HEAPLab/marco-ram-board/bom/marco-ram-board.ods

Component Count: | 188
Ref | Qnty | Value | Cmp name | Footprint
C201, C202, C319, C320, | 4 | 12p | C | Capacitor_SMD:C_0603_1608Metric_Pad1.08x0.95mm_HandSolder
C203, C206, | 2 | 4.7u | C_Polarized | Capacitor_Tantalum_SMD:CP_EIA-2012-15_AVX-P_Pad1.30x1.05mm_HandSolder
C204, C205, C208, C301, C302, C303, C304, C305, C306, C307, C308, C309, C310, C311, C312, C313, C314, C315, C316, C401, C402, C403, C404, C405, C406, C407, C408, C409, C410, C411, C412, C413, C414, C415, C416, C417, C418, C419, C420, C421, C422, C423, C424, C425, C426, C427, C428, C429, C430, C431, C432, C433, C434, C435, C436, C437, C438, C439, C440, C441, C442, C443, C444, C445, C446, C447, C448, C502, C503, C505, C507, C508, C509, | 73 | 100n | C | Capacitor_SMD:C_0603_1608Metric_Pad1.08x0.95mm_HandSolder
C207, | 1 | 3.3u | C | Capacitor_SMD:C_0805_2012Metric_Pad1.18x1.45mm_HandSolder
C317, C318, C501, | 3 | 2.2u | C_Polarized | Capacitor_SMD:C_0805_2012Metric_Pad1.18x1.45mm_HandSolder
C504, C506, | 2 | 22u | C_Polarized | Capacitor_Tantalum_SMD:CP_EIA-3216-18_Kemet-A_Pad1.58x1.35mm_HandSolder
C601, | 1 | 100u | C_Polarized | Capacitor_THT:CP_Radial_D6.3mm_P2.50mm
C602, C603, C604, | 3 | 470u | C_Polarized | Capacitor_THT:CP_Radial_D8.0mm_P5.00mm
D501, D502, D602, | 3 | LED | LED | LED_SMD:LED_PLCC-2_3.4x3.0mm_KA
D601, | 1 | 1N5822 | D_Schottky | Diode_THT:D_DO-201AD_P5.08mm_Vertical_AnodeUp
FB201, FB202, FB501, | 3 | FerriteBead | FerriteBead | Inductor_SMD:L_0603_1608Metric_Pad1.05x0.95mm_HandSolder
J201, J501 | 2 | PRG_USB | USB_B_Micro | Connector_USB:USB_Mini-B_Wuerth_65100516121_Horizontal
J202, | 1 | MCU_RST | Conn_01x02_Male | Connector_PinHeader_2.54mm:PinHeader_1x02_P2.54mm_Vertical
J203, | 1 | MCU_BOOT0 | Conn_01x02_Male | Connector_PinHeader_2.54mm:PinHeader_1x02_P2.54mm_Vertical
J204, | 1 | FT_TXD | Conn_01x02_Male | Connector_PinHeader_2.54mm:PinHeader_1x02_P2.54mm_Vertical
J205, | 1 | FT_RXD | Conn_01x02_Male | Connector_PinHeader_2.54mm:PinHeader_1x02_P2.54mm_Vertical
J206, | 1 | CONN_JTAG | Conn_02x10_Odd_Even | Connector_PinSocket_2.54mm:PinSocket_2x10_P2.54mm_Vertical
J301, | 1 | CONN_MCU_SERIAL | Conn_01x05_Female | Connector_PinSocket_2.54mm:PinSocket_1x05_P2.54mm_Vertical
J302, | 1 | CONN_EXT | Conn_01x15_Female | Connector_PinSocket_2.54mm:PinSocket_1x15_P2.54mm_Vertical
J502, | 1 | SD_Card | SD_Card | marco-ram-board:SD_Hirose_DM1AA_SF_PEJ82
J503, | 1 | CONN_DISP | Conn_02x08_Odd_Even | Connector_PinSocket_2.54mm:PinSocket_2x08_P2.54mm_Vertical
J504, | 1 | RJ45_Amphenol_RJMG1BD3B8K1ANR | RJ45_Amphenol_RJMG1BD3B8K1ANR | Connector_RJ:RJ45_Amphenol_RJMG1BD3B8K1ANR
J601, | 1 | CONN_JACK_12V | Barrel_Jack_MountingPin | Connector_BarrelJack:BarrelJack_CUI_PJ-063AH_Horizontal
J602, | 1 | CONN_SCREW_12V | Screw_Terminal_01x02 | TerminalBlock_Phoenix:TerminalBlock_Phoenix_MKDS-1,5-2-5.08_1x02_P5.08mm_Horizontal
JP501, | 1 | MCU_USB_ID | SolderJumper_2_Open | Jumper:SolderJumper-2_P1.3mm_Open_RoundedPad1.0x1.5mm
L601, | 1 | 68u 5A | L | Inductor_THT:L_Toroid_Vertical_L24.6mm_W15.5mm_P11.44mm_Pulse_KM-4
Q201, | 1 | MMBT3906 | MMBT3906 | Package_TO_SOT_SMD:SOT-23
Q601, | 1 | DMP3037LSS | FDS9435A | Package_SO:SOIC-8_3.9x4.9mm_P1.27mm
R201, | 1 | 12k 1% | R | Resistor_SMD:R_0603_1608Metric_Pad0.98x0.95mm_HandSolder
R202, R206, R211, R517, R520, R522, R523, R524, R525, R601, | 9 | 1k | R | Resistor_SMD:R_0603_1608Metric_Pad0.98x0.95mm_HandSolder
R203, R210, R301, R302, R303, R504, R526, | 6 | 10k | R | Resistor_SMD:R_0603_1608Metric_Pad0.98x0.95mm_HandSolder
R204, R205, R207, R208, R209, R305, R306, R307, R508, R509, R510, R511, R512, R513, R514, | 15 | 0 | R | Resistor_SMD:R_0603_1608Metric_Pad0.98x0.95mm_HandSolder
R304, R518, R521, R505, R515, | 3 | 220 | R | Resistor_SMD:R_0603_1608Metric_Pad0.98x0.95mm_HandSolder
R501, R502, R503, R506, R507, R527, R528, | 7 | 47k | R | Resistor_SMD:R_0603_1608Metric_Pad0.98x0.95mm_HandSolder
R516, | 1 | 6.49k | R | Resistor_SMD:R_0603_1608Metric_Pad0.98x0.95mm_HandSolder
R519, | 1 | 4.7k | R | Resistor_SMD:R_0603_1608Metric_Pad0.98x0.95mm_HandSolder
SW301, | 1 | SW_RST | SW_Push | marco-ram-board:DTSMW69N
SW302, | 1 | SW_BOOT0 | SW_Push | marco-ram-board:DTSMW69N
SW501, | 1 | BTN0 | SW_Push | marco-ram-board:DTSMW69N
SW502, | 1 | BTN1 | SW_Push | marco-ram-board:DTSMW69N
SW503, | 1 | BTN2 | SW_Push | marco-ram-board:DTSMW69N
SW504, | 1 | BTN3 | SW_Push | marco-ram-board:DTSMW69N
SW601, | 1 | PWR_SW | SW_SPDT | marco-ram-board:SW_Slide_CuK_1101M2xxAxx2_SPDT_RightAngle
U201, | 1 | FT2232HL | FT2232HL | Package_QFP:LQFP-64_10x10mm_P0.5mm
U301, | 1 | STM32F765IITx | STM32F765IITx | Package_QFP:LQFP-176_24x24mm_P0.5mm
U401, U402, U403, U404, U405, U406, U407, U408, | 8 | IS42S86400D | IS42S86400D_3 | Package_SO:TSOP-II-54_22.2x10.16mm_P0.8mm
U501, | 1 | KSZ8081RNA | KSZ8081RNA | Package_DFN_QFN:QFN-24-1EP_4x4mm_P0.5mm_EP2.6x2.6mm
U601, | 1 | LM2576S-3.3 | LM2576S-3.3 | Package_TO_SOT_SMD:TO-263-5_TabPin3
Y201, | 1 | 12MHz | Crystal_GND24 | Crystal:Crystal_SMD_5032-4Pin_5.0x3.2mm
Y301, | 1 | 25MHz | Crystal_GND24 | Crystal:Crystal_SMD_5032-4Pin_5.0x3.2mm
