HEAPLab/marco-ram-board/pdf_schematic/marco-ram-board.pdf

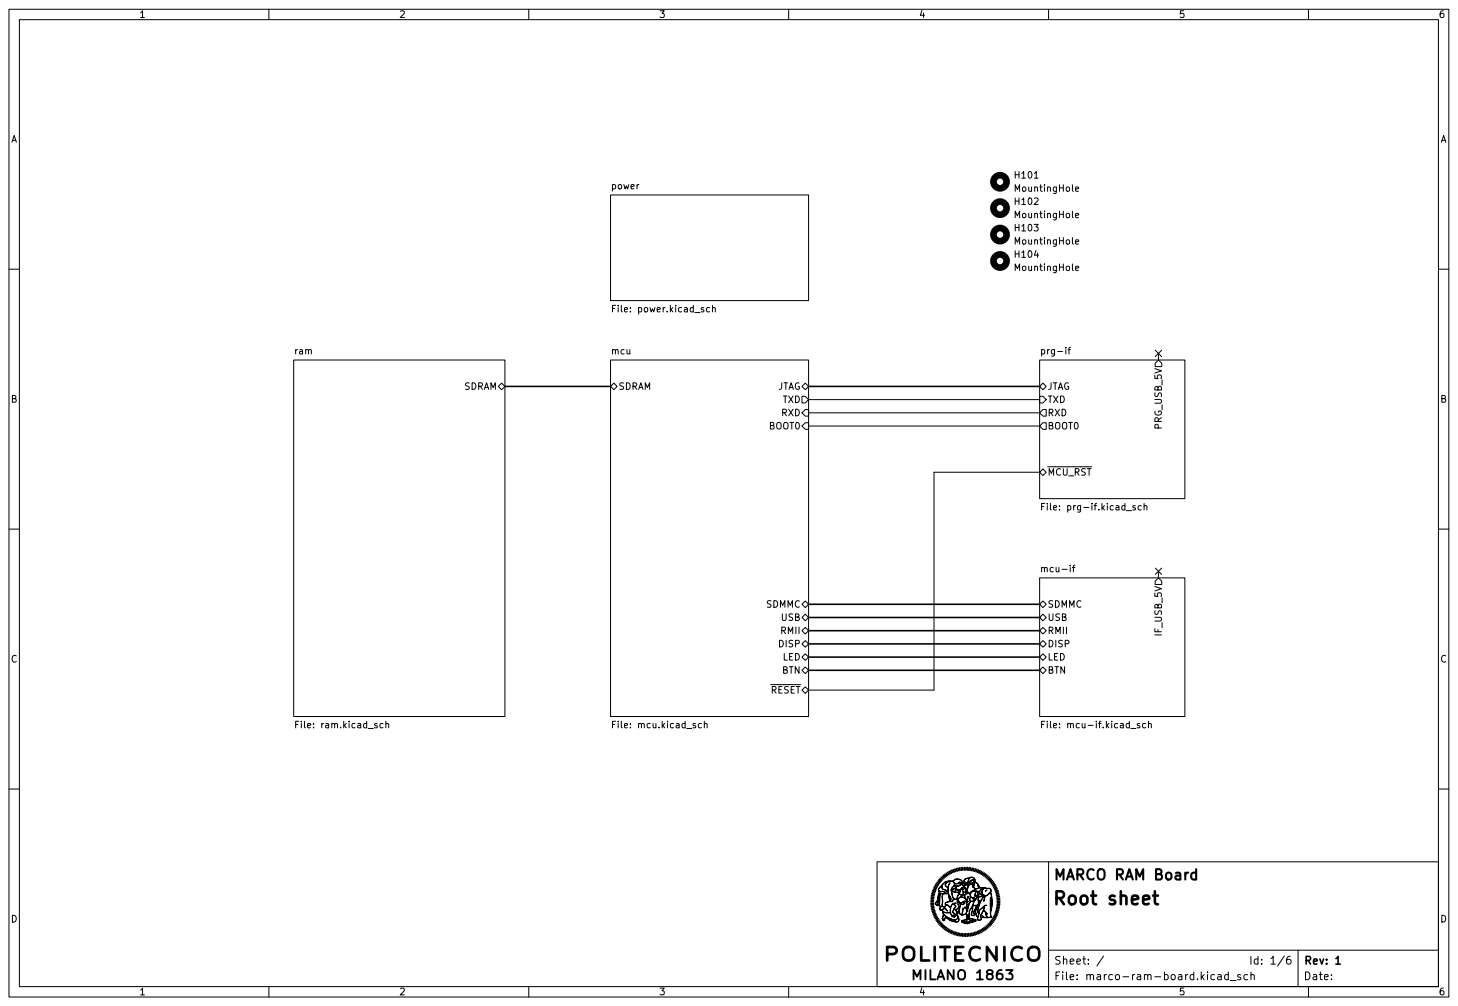
[picture p1: page 1]

BTN mcu File: mcu.kicad_sch

prg-if File: prg-if.kicad_sch SDMMC

LED mcu-if File: mcu-if.kicad_sch SDRAM

File: marco-ram-board.kicad_sch Sheet: / Root sheet

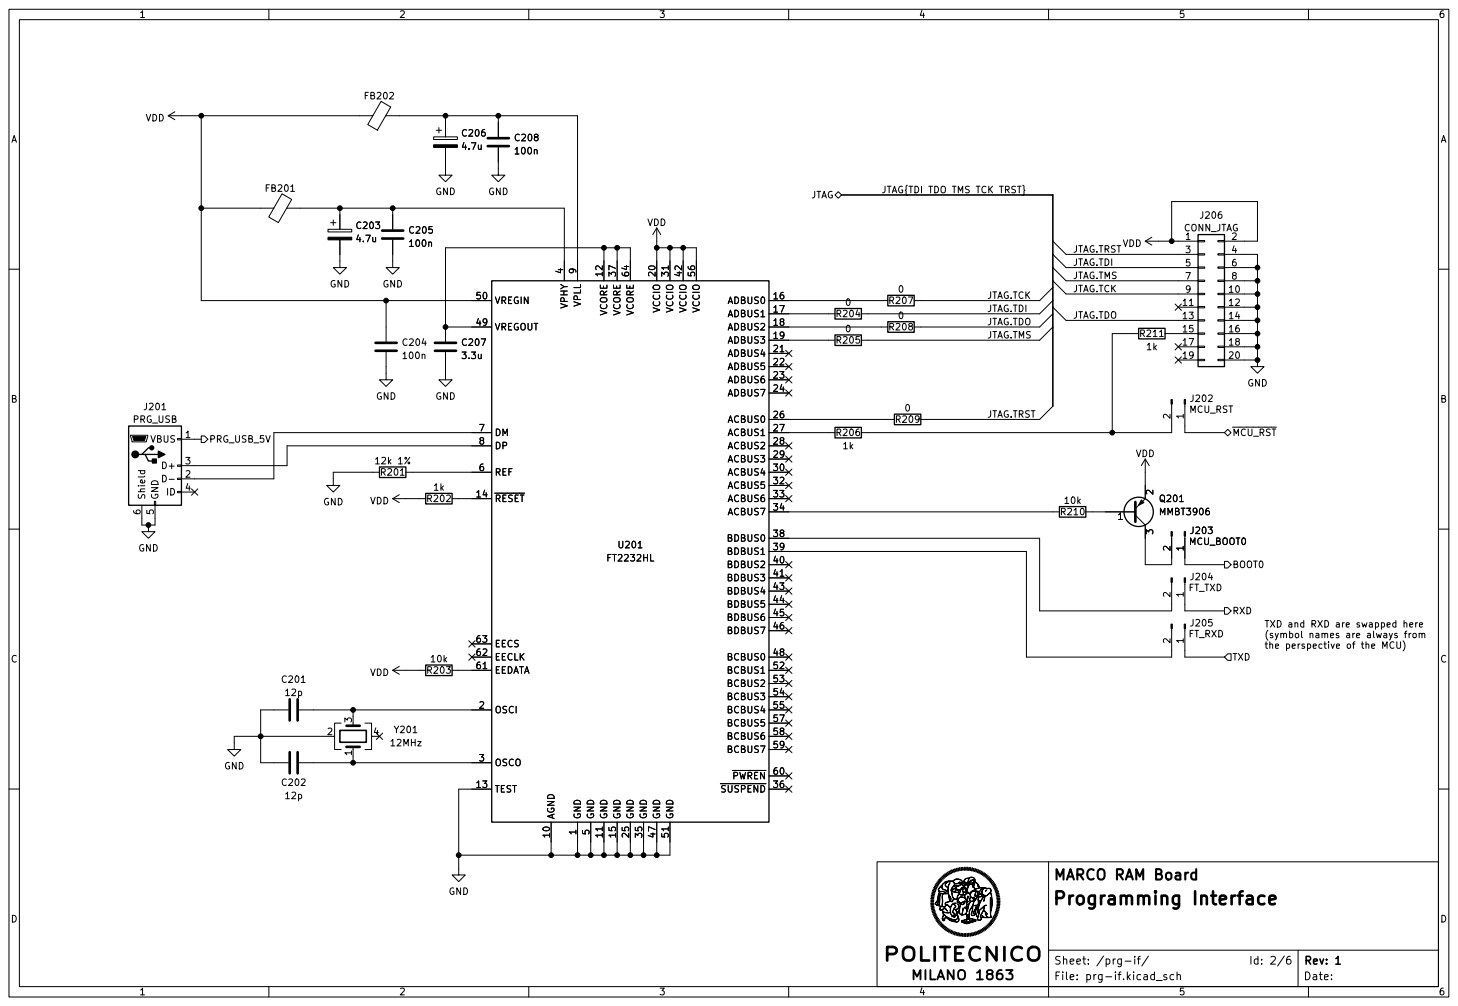
[picture p2: page 2]

1 AGND 10 GND 11 VCORE 12 TEST 13 ~{RESET} 14 GND 15 ADBUS0 16 ADBUS1 17 ADBUS2 18 ADBUS3 19 OSCI 2 VCCIO 20 ADBUS4 21 ADBUS5 22 ADBUS6 23 ADBUS7 24 GND 25 ACBUS0 26 ACBUS1 27 ACBUS2 28 ACBUS3 29 OSCO 3 ACBUS4 30 VCCIO 31 ACBUS5 32 ACBUS6 33 ACBUS7 34 GND 35

4 BDBUS2 40 BDBUS3 41 VCCIO 42 BDBUS4 43 BDBUS5 44 BDBUS6 45 BDBUS7 46 GND 47 BCBUS0 48 VREGOUT 49 GND

5 VREGIN 50 GND 51 BCBUS1 52 BCBUS2 53 BCBUS3 54 BCBUS4 55 VCCIO 56 BCBUS5 57 BCBUS6 58 BCBUS7 59 REF

JTAG.TDI JTAG.TRST

TXD and RXD are swapped here
(symbol names are always from

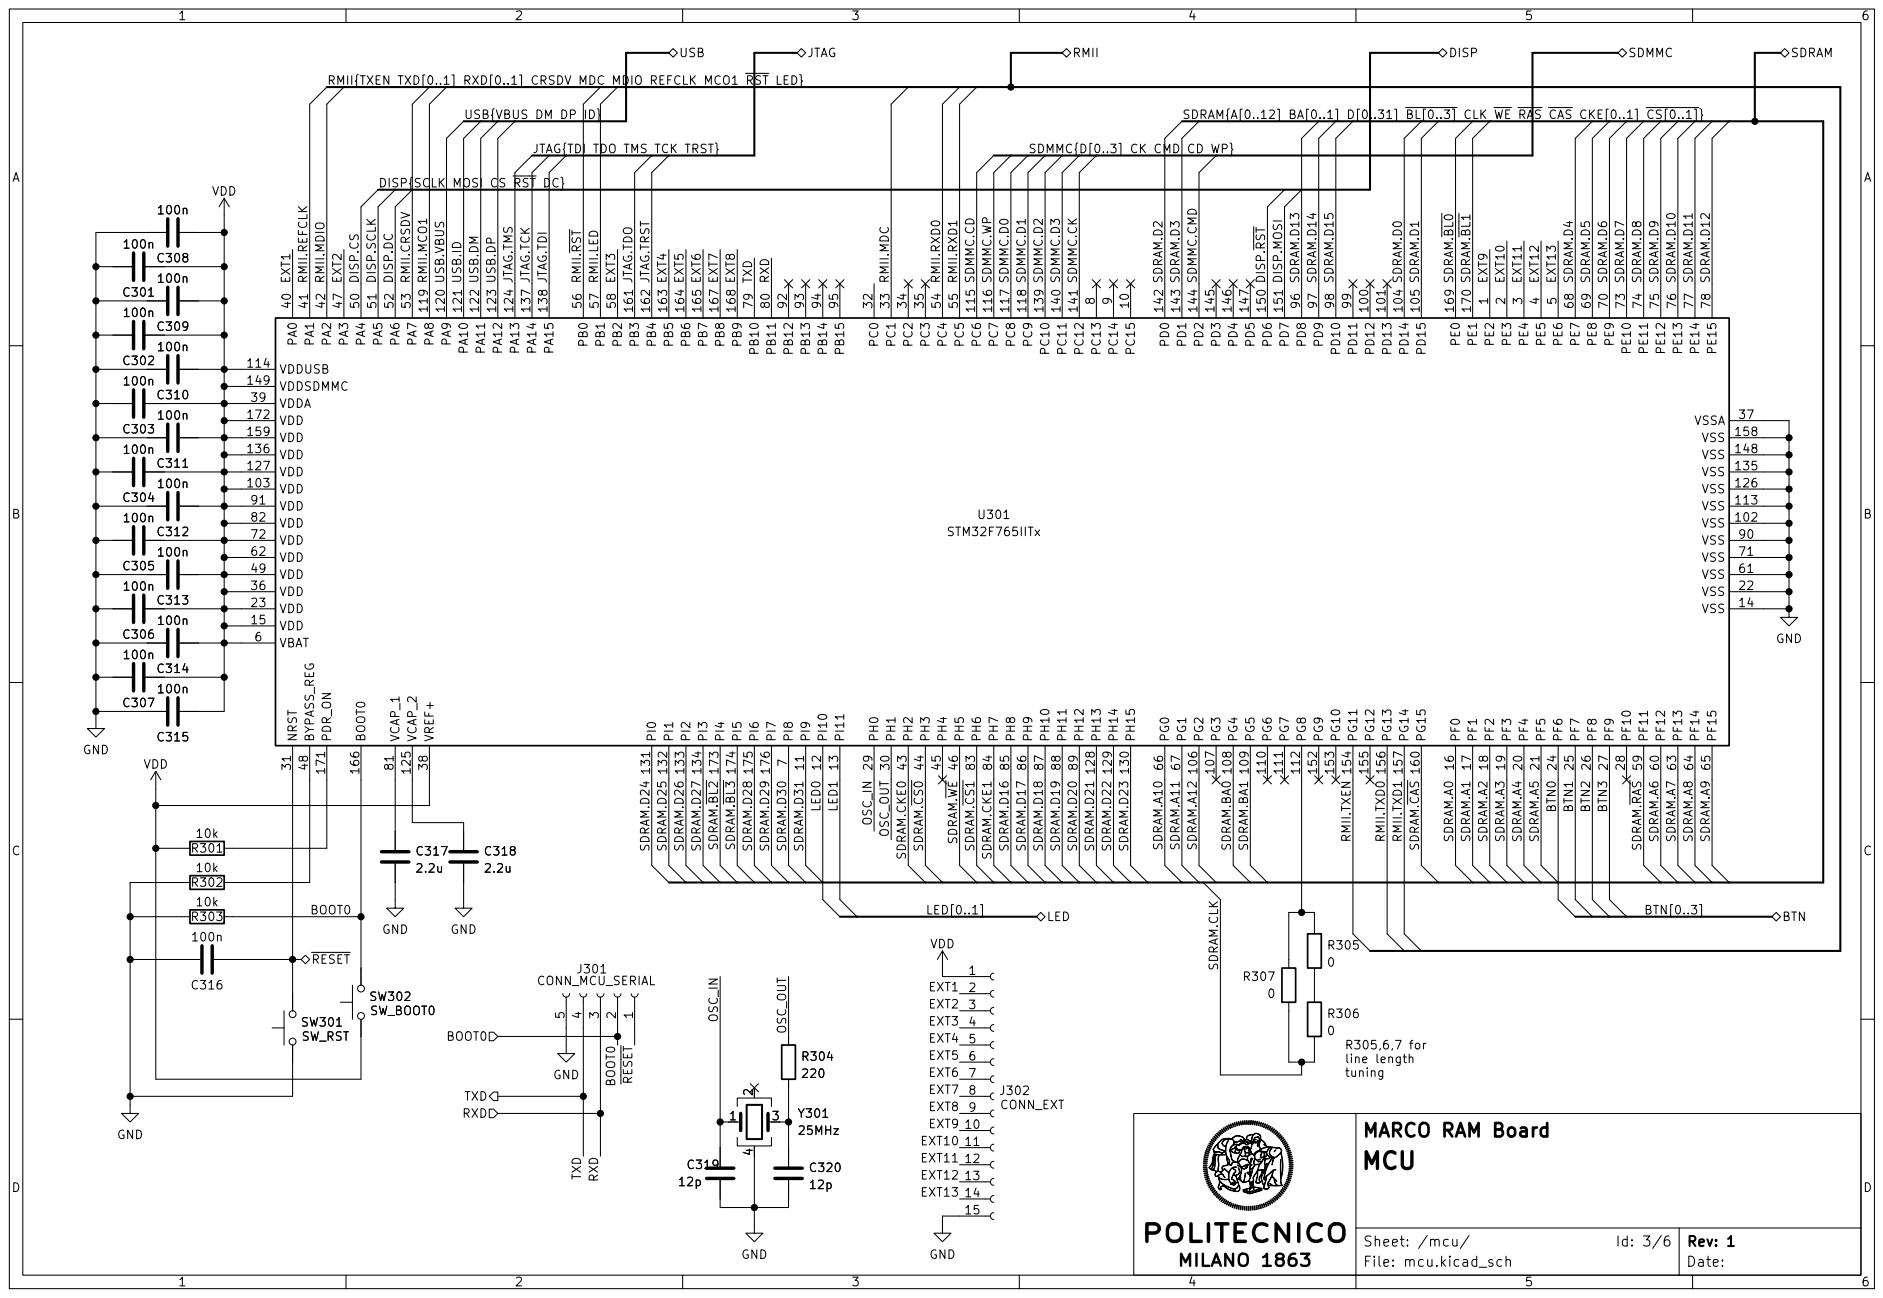
[picture p3: page 3]

File: mcu.kicad_sch Sheet: /mcu/ MCU

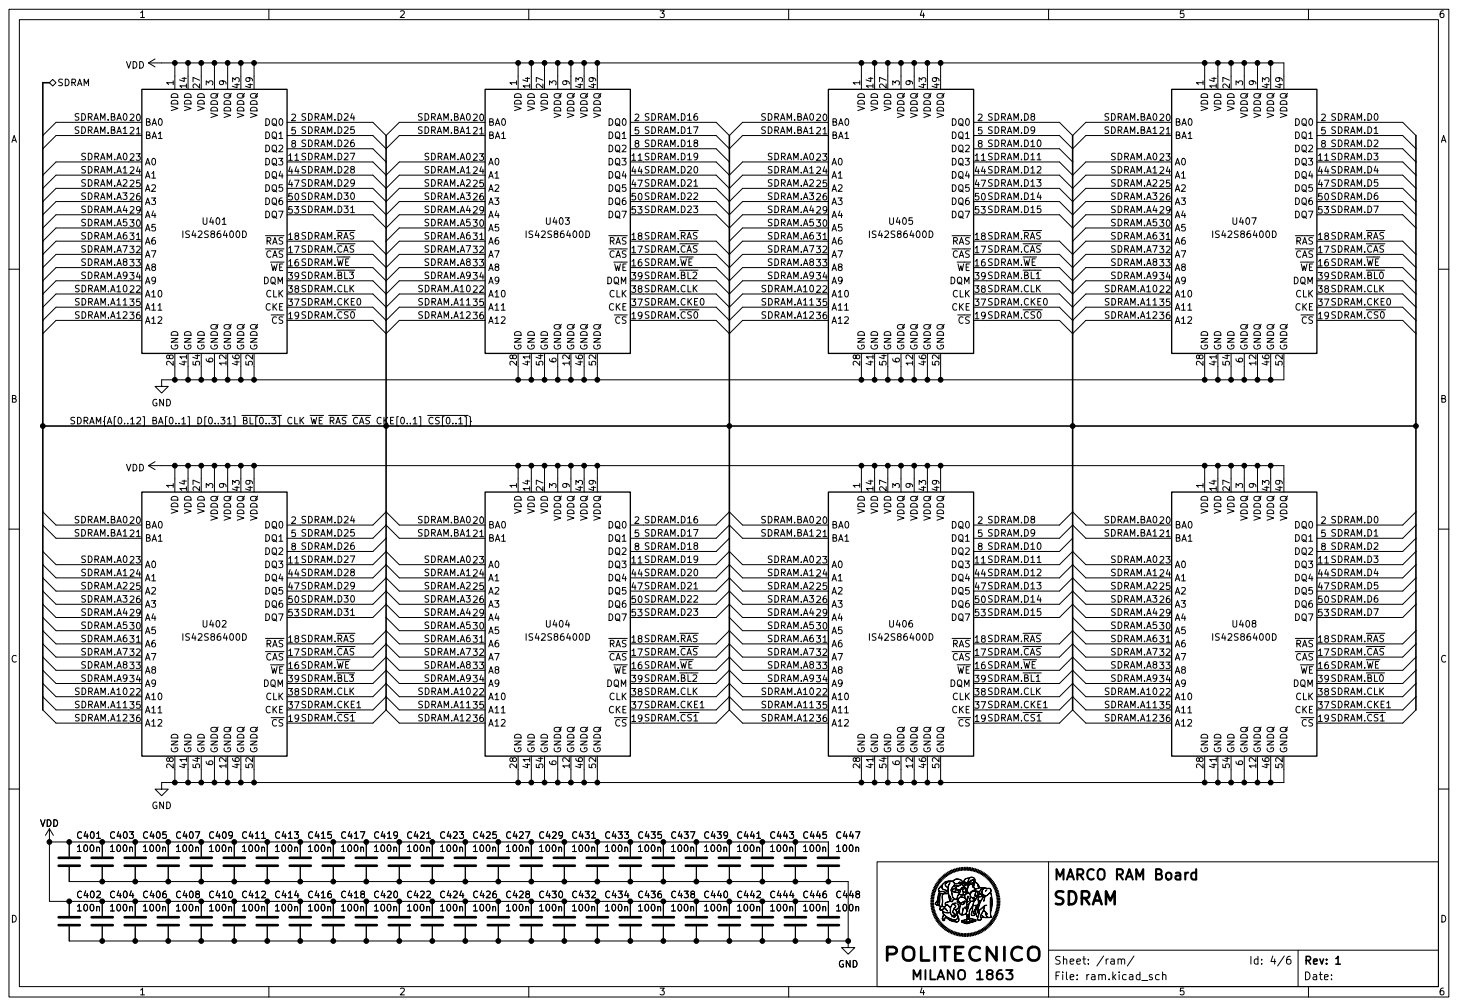
[picture p4: page 4]

SDRAM.~{CAS} SDRAM.A4 SDRAM.~{BL2} SDRAM.CLK

File: ram.kicad_sch Sheet: /ram/ SDRAM

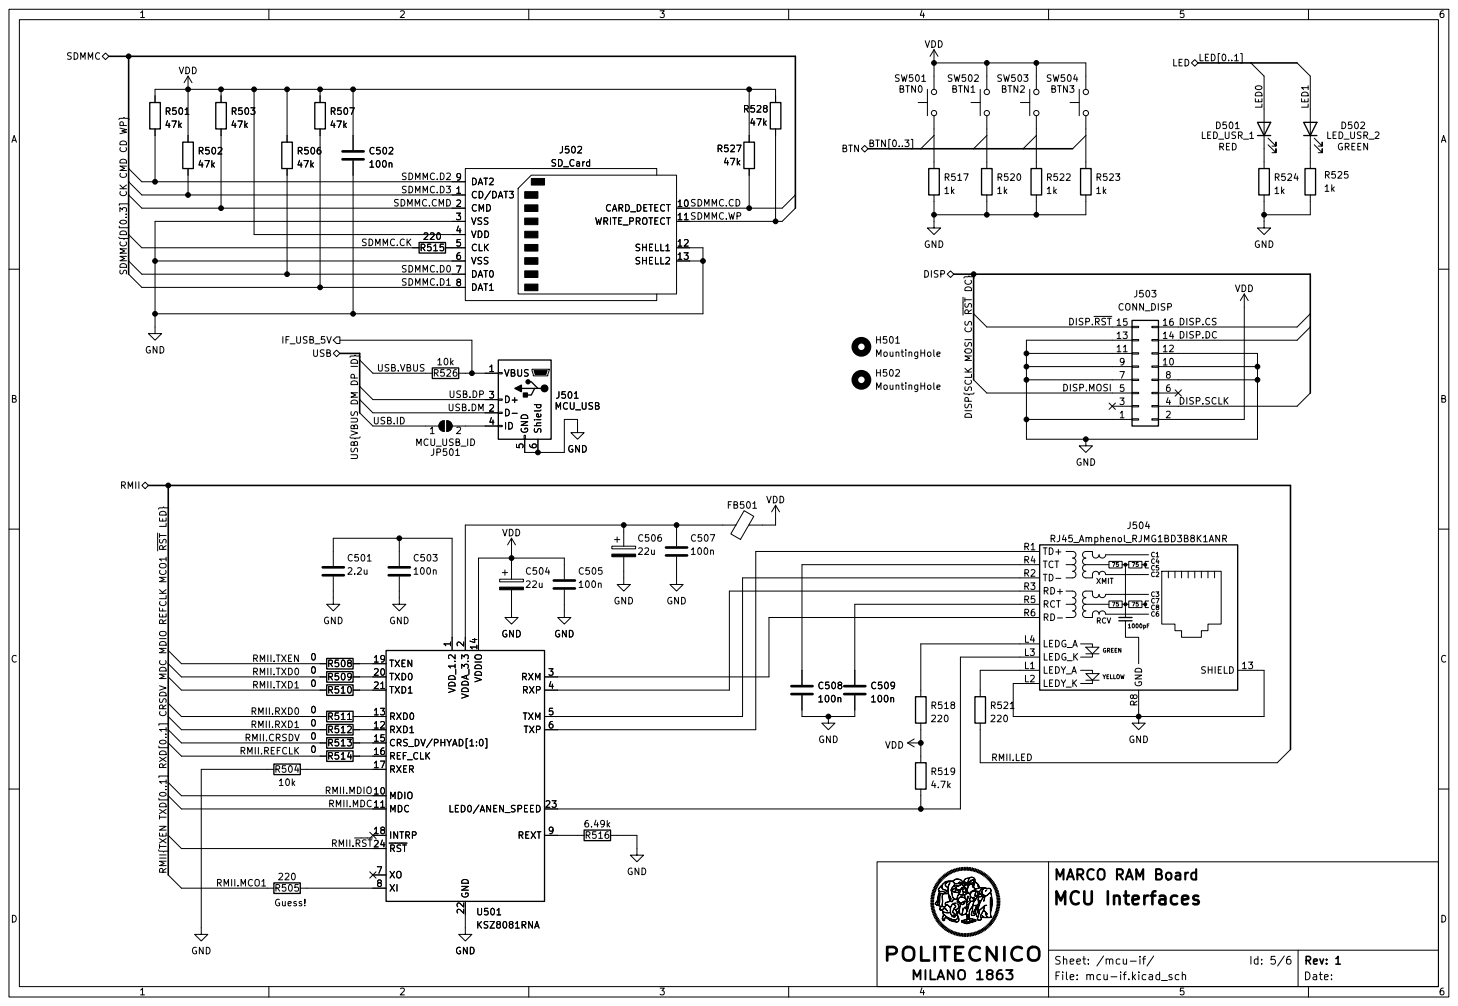
[picture p5: page 5]

11 | 12
9 | 10

RMII.MDIO
RMII.~{RST} RMII.MDC

File: mcu-if.kicad_sch Sheet: /mcu-if/ MCU Interfaces

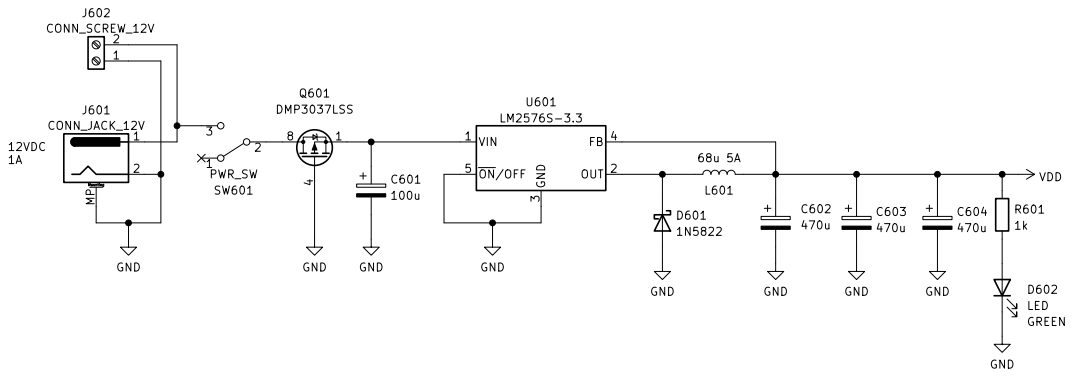
[picture p6: page 6]
