HEAPLab/marco-ram-board/marco-ram-board.kicad_pcb

## KiCad design marco-ram-board.kicad_pcb (2023-04-23)

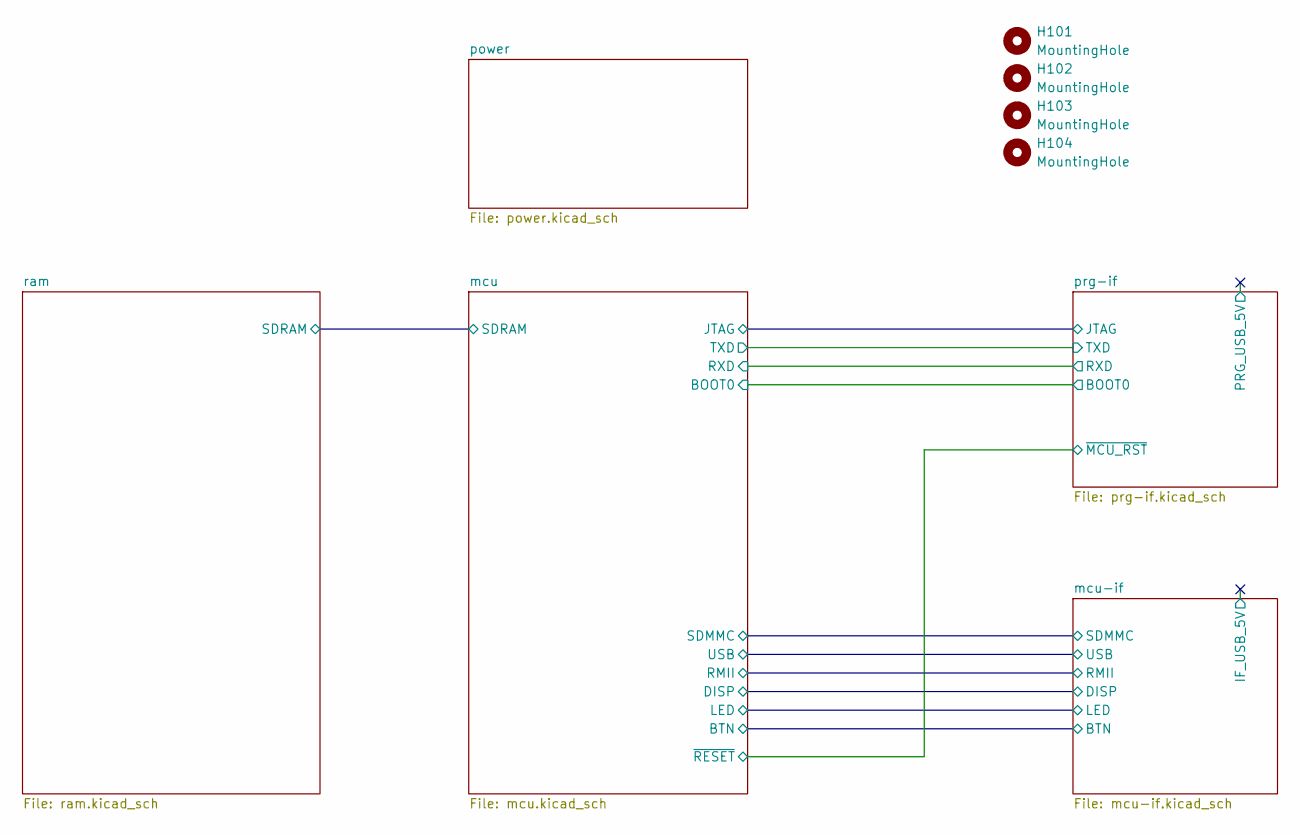
[picture p7: schematic marco-ram-board.kicad_sch, MARCO RAM Board]

Parts:
H101, H102, H103, H104: MountingHole; MountingHole_3.2mm_M3

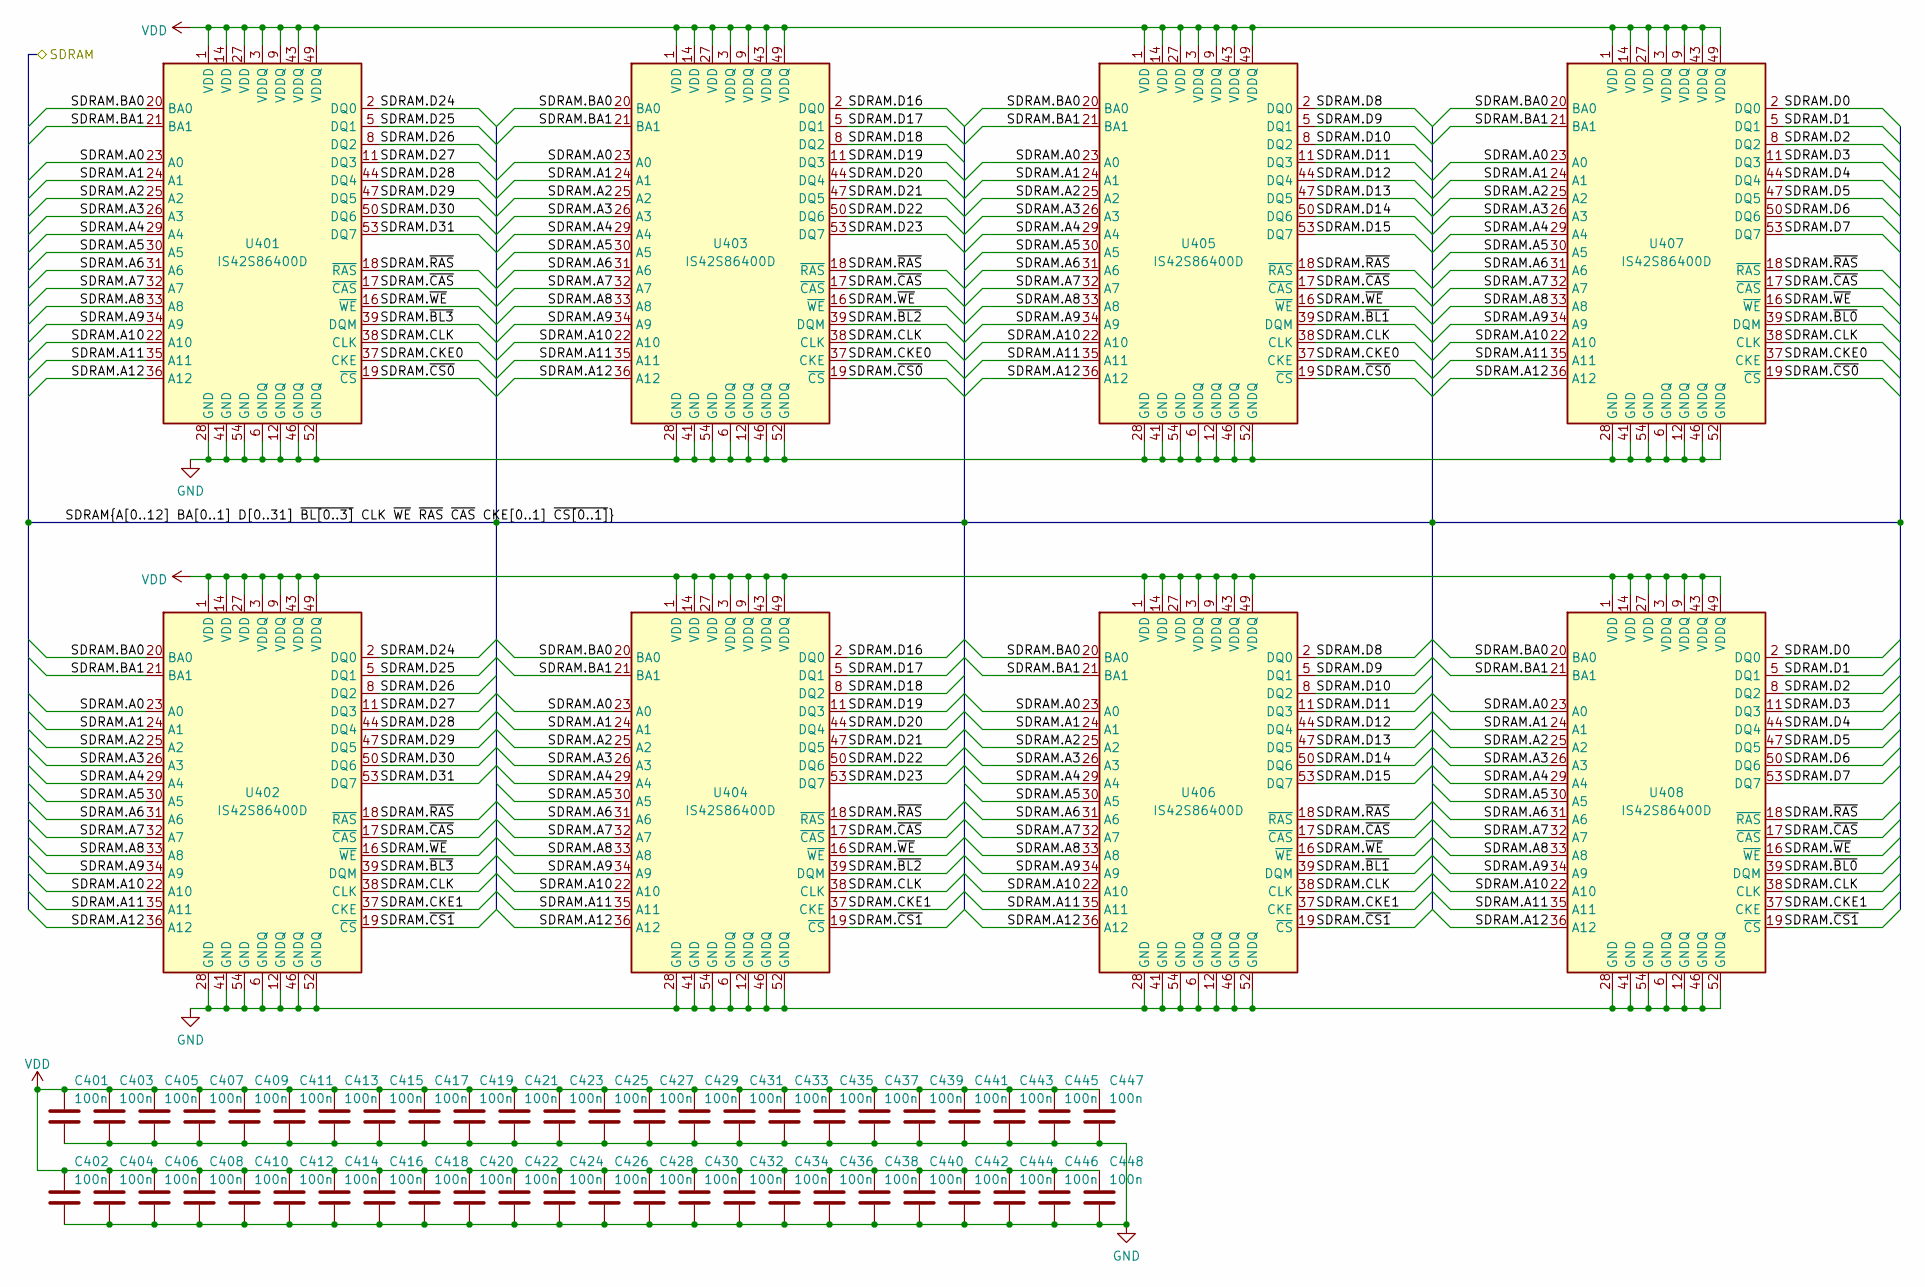
[picture p8: schematic ram.kicad_sch, MARCO RAM Board]

Parts:
C401, C402, C403, C404, C405, C406, C407, C408, C409, C410, C411, C412, C413, C414, C415, C416, C417, C418, C419, C420, C421, C422, C423, C424, C425, C426, C427, C428, C429, C430, C431, C432, C433, C434, C435, C436, C437, C438, C439, C440, C441, C442, C443, C444, C445, C446, C447, C448: 100n; C_0603_1608Metric_Pad1.08x0.95mm_HandSolder
U401, U402, U403, U404, U405, U406, U407, U408: IS42S86400D; TSOP-II-54_22.2x10.16mm_P0.8mm

Connections:
/mcu/SDRAM.A0: U401.23 (A0), U402.23 (A0), U403.23 (A0), U404.23 (A0), U405.23 (A0), U406.23 (A0), U407.23 (A0), U408.23 (A0); also elsewhere on the board
/mcu/SDRAM.A1: U401.24 (A1), U402.24 (A1), U403.24 (A1), U404.24 (A1), U405.24 (A1), U406.24 (A1), U407.24 (A1), U408.24 (A1); also elsewhere on the board
/mcu/SDRAM.A2: U401.25 (A2), U402.25 (A2), U403.25 (A2), U404.25 (A2), U405.25 (A2), U406.25 (A2), U407.25 (A2), U408.25 (A2); also elsewhere on the board
/mcu/SDRAM.A3: U401.26 (A3), U402.26 (A3), U403.26 (A3), U404.26 (A3), U405.26 (A3), U406.26 (A3), U407.26 (A3), U408.26 (A3); also elsewhere on the board
/mcu/SDRAM.A4: U401.29 (A4), U402.29 (A4), U403.29 (A4), U404.29 (A4), U405.29 (A4), U406.29 (A4), U407.29 (A4), U408.29 (A4); also elsewhere on the board
/mcu/SDRAM.A5: U401.30 (A5), U402.30 (A5), U403.30 (A5), U404.30 (A5), U405.30 (A5), U406.30 (A5), U407.30 (A5), U408.30 (A5); also elsewhere on the board
/mcu/SDRAM.A6: U401.31 (A6), U402.31 (A6), U403.31 (A6), U404.31 (A6), U405.31 (A6), U406.31 (A6), U407.31 (A6), U408.31 (A6); also elsewhere on the board
/mcu/SDRAM.A7: U401.32 (A7), U402.32 (A7), U403.32 (A7), U404.32 (A7), U405.32 (A7), U406.32 (A7), U407.32 (A7), U408.32 (A7); also elsewhere on the board
/mcu/SDRAM.A8: U401.33 (A8), U402.33 (A8), U403.33 (A8), U404.33 (A8), U405.33 (A8), U406.33 (A8), U407.33 (A8), U408.33 (A8); also elsewhere on the board
/mcu/SDRAM.A9: U401.34 (A9), U402.34 (A9), U403.34 (A9), U404.34 (A9), U405.34 (A9), U406.34 (A9), U407.34 (A9), U408.34 (A9); also elsewhere on the board
/mcu/SDRAM.A10: U401.22 (A10), U402.22 (A10), U403.22 (A10), U404.22 (A10), U405.22 (A10), U406.22 (A10), U407.22 (A10), U408.22 (A10); also elsewhere on the board
/mcu/SDRAM.A11: U401.35 (A11), U402.35 (A11), U403.35 (A11), U404.35 (A11), U405.35 (A11), U406.35 (A11), U407.35 (A11), U408.35 (A11); also elsewhere on the board
/mcu/SDRAM.A12: U401.36 (A12), U402.36 (A12), U403.36 (A12), U404.36 (A12), U405.36 (A12), U406.36 (A12), U407.36 (A12), U408.36 (A12); also elsewhere on the board
/mcu/SDRAM.BA0: U401.20 (BA0), U402.20 (BA0), U403.20 (BA0), U404.20 (BA0), U405.20 (BA0), U406.20 (BA0), U407.20 (BA0), U408.20 (BA0); also elsewhere on the board
/mcu/SDRAM.BA1: U401.21 (BA1), U402.21 (BA1), U403.21 (BA1), U404.21 (BA1), U405.21 (BA1), U406.21 (BA1), U407.21 (BA1), U408.21 (BA1); also elsewhere on the board
/mcu/SDRAM.CKE0: U401.37 (CKE), U403.37 (CKE), U405.37 (CKE), U407.37 (CKE); also elsewhere on the board
/mcu/SDRAM.CKE1: U402.37 (CKE), U404.37 (CKE), U406.37 (CKE), U408.37 (CKE); also elsewhere on the board
/mcu/SDRAM.CLK: U401.38 (CLK), U402.38 (CLK), U403.38 (CLK), U404.38 (CLK), U405.38 (CLK), U406.38 (CLK), U407.38 (CLK), U408.38 (CLK); also elsewhere on the board
/mcu/SDRAM.D0: U407.2 (DQ0), U408.2 (DQ0); also elsewhere on the board
/mcu/SDRAM.D1: U407.5 (DQ1), U408.5 (DQ1); also elsewhere on the board
/mcu/SDRAM.D2: U407.8 (DQ2), U408.8 (DQ2); also elsewhere on the board
/mcu/SDRAM.D3: U407.11 (DQ3), U408.11 (DQ3); also elsewhere on the board
/mcu/SDRAM.D4: U407.44 (DQ4), U408.44 (DQ4); also elsewhere on the board
/mcu/SDRAM.D5: U407.47 (DQ5), U408.47 (DQ5); also elsewhere on the board
/mcu/SDRAM.D6: U407.50 (DQ6), U408.50 (DQ6); also elsewhere on the board
/mcu/SDRAM.D7: U407.53 (DQ7), U408.53 (DQ7); also elsewhere on the board
/mcu/SDRAM.D8: U405.2 (DQ0), U406.2 (DQ0); also elsewhere on the board
/mcu/SDRAM.D9: U405.5 (DQ1), U406.5 (DQ1); also elsewhere on the board
/mcu/SDRAM.D10: U405.8 (DQ2), U406.8 (DQ2); also elsewhere on the board
/mcu/SDRAM.D11: U405.11 (DQ3), U406.11 (DQ3); also elsewhere on the board
/mcu/SDRAM.D12: U405.44 (DQ4), U406.44 (DQ4); also elsewhere on the board
/mcu/SDRAM.D13: U405.47 (DQ5), U406.47 (DQ5); also elsewhere on the board
/mcu/SDRAM.D14: U405.50 (DQ6), U406.50 (DQ6); also elsewhere on the board
/mcu/SDRAM.D15: U405.53 (DQ7), U406.53 (DQ7); also elsewhere on the board
/mcu/SDRAM.D16: U403.2 (DQ0), U404.2 (DQ0); also elsewhere on the board
/mcu/SDRAM.D17: U403.5 (DQ1), U404.5 (DQ1); also elsewhere on the board
/mcu/SDRAM.D18: U403.8 (DQ2), U404.8 (DQ2); also elsewhere on the board
/mcu/SDRAM.D19: U403.11 (DQ3), U404.11 (DQ3); also elsewhere on the board
/mcu/SDRAM.D20: U403.44 (DQ4), U404.44 (DQ4); also elsewhere on the board
/mcu/SDRAM.D21: U403.47 (DQ5), U404.47 (DQ5); also elsewhere on the board
/mcu/SDRAM.D22: U403.50 (DQ6), U404.50 (DQ6); also elsewhere on the board
/mcu/SDRAM.D23: U403.53 (DQ7), U404.53 (DQ7); also elsewhere on the board
/mcu/SDRAM.D24: U401.2 (DQ0), U402.2 (DQ0); also elsewhere on the board
/mcu/SDRAM.D25: U401.5 (DQ1), U402.5 (DQ1); also elsewhere on the board
/mcu/SDRAM.D26: U401.8 (DQ2), U402.8 (DQ2); also elsewhere on the board
/mcu/SDRAM.D27: U401.11 (DQ3), U402.11 (DQ3); also elsewhere on the board
/mcu/SDRAM.D28: U401.44 (DQ4), U402.44 (DQ4); also elsewhere on the board
/mcu/SDRAM.D29: U401.47 (DQ5), U402.47 (DQ5); also elsewhere on the board
/mcu/SDRAM.D30: U401.50 (DQ6), U402.50 (DQ6); also elsewhere on the board
/mcu/SDRAM.D31: U401.53 (DQ7), U402.53 (DQ7); also elsewhere on the board
/mcu/SDRAM.~BL0: U407.39 (DQM), U408.39 (DQM); also elsewhere on the board
/mcu/SDRAM.~BL1: U405.39 (DQM), U406.39 (DQM); also elsewhere on the board
/mcu/SDRAM.~BL2: U403.39 (DQM), U404.39 (DQM); also elsewhere on the board
/mcu/SDRAM.~BL3: U401.39 (DQM), U402.39 (DQM); also elsewhere on the board
/mcu/SDRAM.~CAS: U401.17 (~CAS), U402.17 (~CAS), U403.17 (~CAS), U404.17 (~CAS), U405.17 (~CAS), U406.17 (~CAS), U407.17 (~CAS), U408.17 (~CAS); also elsewhere on the board
/mcu/SDRAM.~CS0: U401.19 (~CS), U403.19 (~CS), U405.19 (~CS), U407.19 (~CS); also elsewhere on the board
/mcu/SDRAM.~CS1: U402.19 (~CS), U404.19 (~CS), U406.19 (~CS), U408.19 (~CS); also elsewhere on the board
/mcu/SDRAM.~RAS: U401.18 (~RAS), U402.18 (~RAS), U403.18 (~RAS), U404.18 (~RAS), U405.18 (~RAS), U406.18 (~RAS), U407.18 (~RAS), U408.18 (~RAS); also elsewhere on the board
/mcu/SDRAM.~WE: U401.16 (~WE), U402.16 (~WE), U403.16 (~WE), U404.16 (~WE), U405.16 (~WE), U406.16 (~WE), U407.16 (~WE), U408.16 (~WE); also elsewhere on the board
GND: C401.2, C402.2, C403.2, C404.2, C405.2, C406.2, C407.2, C408.2, C409.2, C410.2, C411.2, C412.2, C413.2, C414.2, C415.2, C416.2, C417.2, C418.2, C419.2, C420.2, C421.2, C422.2, C423.2, C424.2, C425.2, C426.2, C427.2, C428.2, C429.2, C430.2, C431.2, C432.2, C433.2, C434.2, C435.2, C436.2, C437.2, C438.2, C439.2, C440.2, C441.2, C442.2, C443.2, C444.2, C445.2, C446.2, C447.2, C448.2, U401.6 (GNDQ), U401.12 (GNDQ), U401.28 (GND), U401.41 (GND), U401.46 (GNDQ), U401.52 (GNDQ), U401.54 (GND), U402.6 (GNDQ), U402.12 (GNDQ), U402.28 (GND), U402.41 (GND), U402.46 (GNDQ), U402.52 (GNDQ), U402.54 (GND), U403.6 (GNDQ), U403.12 (GNDQ), U403.28 (GND), U403.41 (GND), U403.46 (GNDQ), U403.52 (GNDQ), U403.54 (GND), U404.6 (GNDQ), U404.12 (GNDQ), U404.28 (GND), U404.41 (GND), U404.46 (GNDQ), U404.52 (GNDQ), U404.54 (GND), U405.6 (GNDQ), U405.12 (GNDQ), U405.28 (GND), U405.41 (GND), U405.46 (GNDQ), U405.52 (GNDQ), U405.54 (GND), U406.6 (GNDQ), U406.12 (GNDQ), U406.28 (GND), U406.41 (GND), U406.46 (GNDQ), U406.52 (GNDQ), U406.54 (GND), U407.6 (GNDQ), U407.12 (GNDQ), U407.28 (GND), U407.41 (GND), U407.46 (GNDQ), U407.52 (GNDQ), U407.54 (GND), U408.6 (GNDQ), U408.12 (GNDQ), U408.28 (GND), U408.41 (GND), U408.46 (GNDQ), U408.52 (GNDQ), U408.54 (GND); also elsewhere on the board
VDD: C401.1, C402.1, C403.1, C404.1, C405.1, C406.1, C407.1, C408.1, C409.1, C410.1, C411.1, C412.1, C413.1, C414.1, C415.1, C416.1, C417.1, C418.1, C419.1, C420.1, C421.1, C422.1, C423.1, C424.1, C425.1, C426.1, C427.1, C428.1, C429.1, C430.1, C431.1, C432.1, C433.1, C434.1, C435.1, C436.1, C437.1, C438.1, C439.1, C440.1, C441.1, C442.1, C443.1, C444.1, C445.1, C446.1, C447.1, C448.1, U401.1 (VDD), U401.3 (VDDQ), U401.9 (VDDQ), U401.14 (VDD), U401.27 (VDD), U401.43 (VDDQ), U401.49 (VDDQ), U402.1 (VDD), U402.3 (VDDQ), U402.9 (VDDQ), U402.14 (VDD), U402.27 (VDD), U402.43 (VDDQ), U402.49 (VDDQ), U403.1 (VDD), U403.3 (VDDQ), U403.9 (VDDQ), U403.14 (VDD), U403.27 (VDD), U403.43 (VDDQ), U403.49 (VDDQ), U404.1 (VDD), U404.3 (VDDQ), U404.9 (VDDQ), U404.14 (VDD), U404.27 (VDD), U404.43 (VDDQ), U404.49 (VDDQ), U405.1 (VDD), U405.3 (VDDQ), U405.9 (VDDQ), U405.14 (VDD), U405.27 (VDD), U405.43 (VDDQ), U405.49 (VDDQ), U406.1 (VDD), U406.3 (VDDQ), U406.9 (VDDQ), U406.14 (VDD), U406.27 (VDD), U406.43 (VDDQ), U406.49 (VDDQ), U407.1 (VDD), U407.3 (VDDQ), U407.9 (VDDQ), U407.14 (VDD), U407.27 (VDD), U407.43 (VDDQ), U407.49 (VDDQ), U408.1 (VDD), U408.3 (VDDQ), U408.9 (VDDQ), U408.14 (VDD), U408.27 (VDD), U408.43 (VDDQ), U408.49 (VDDQ); also elsewhere on the board

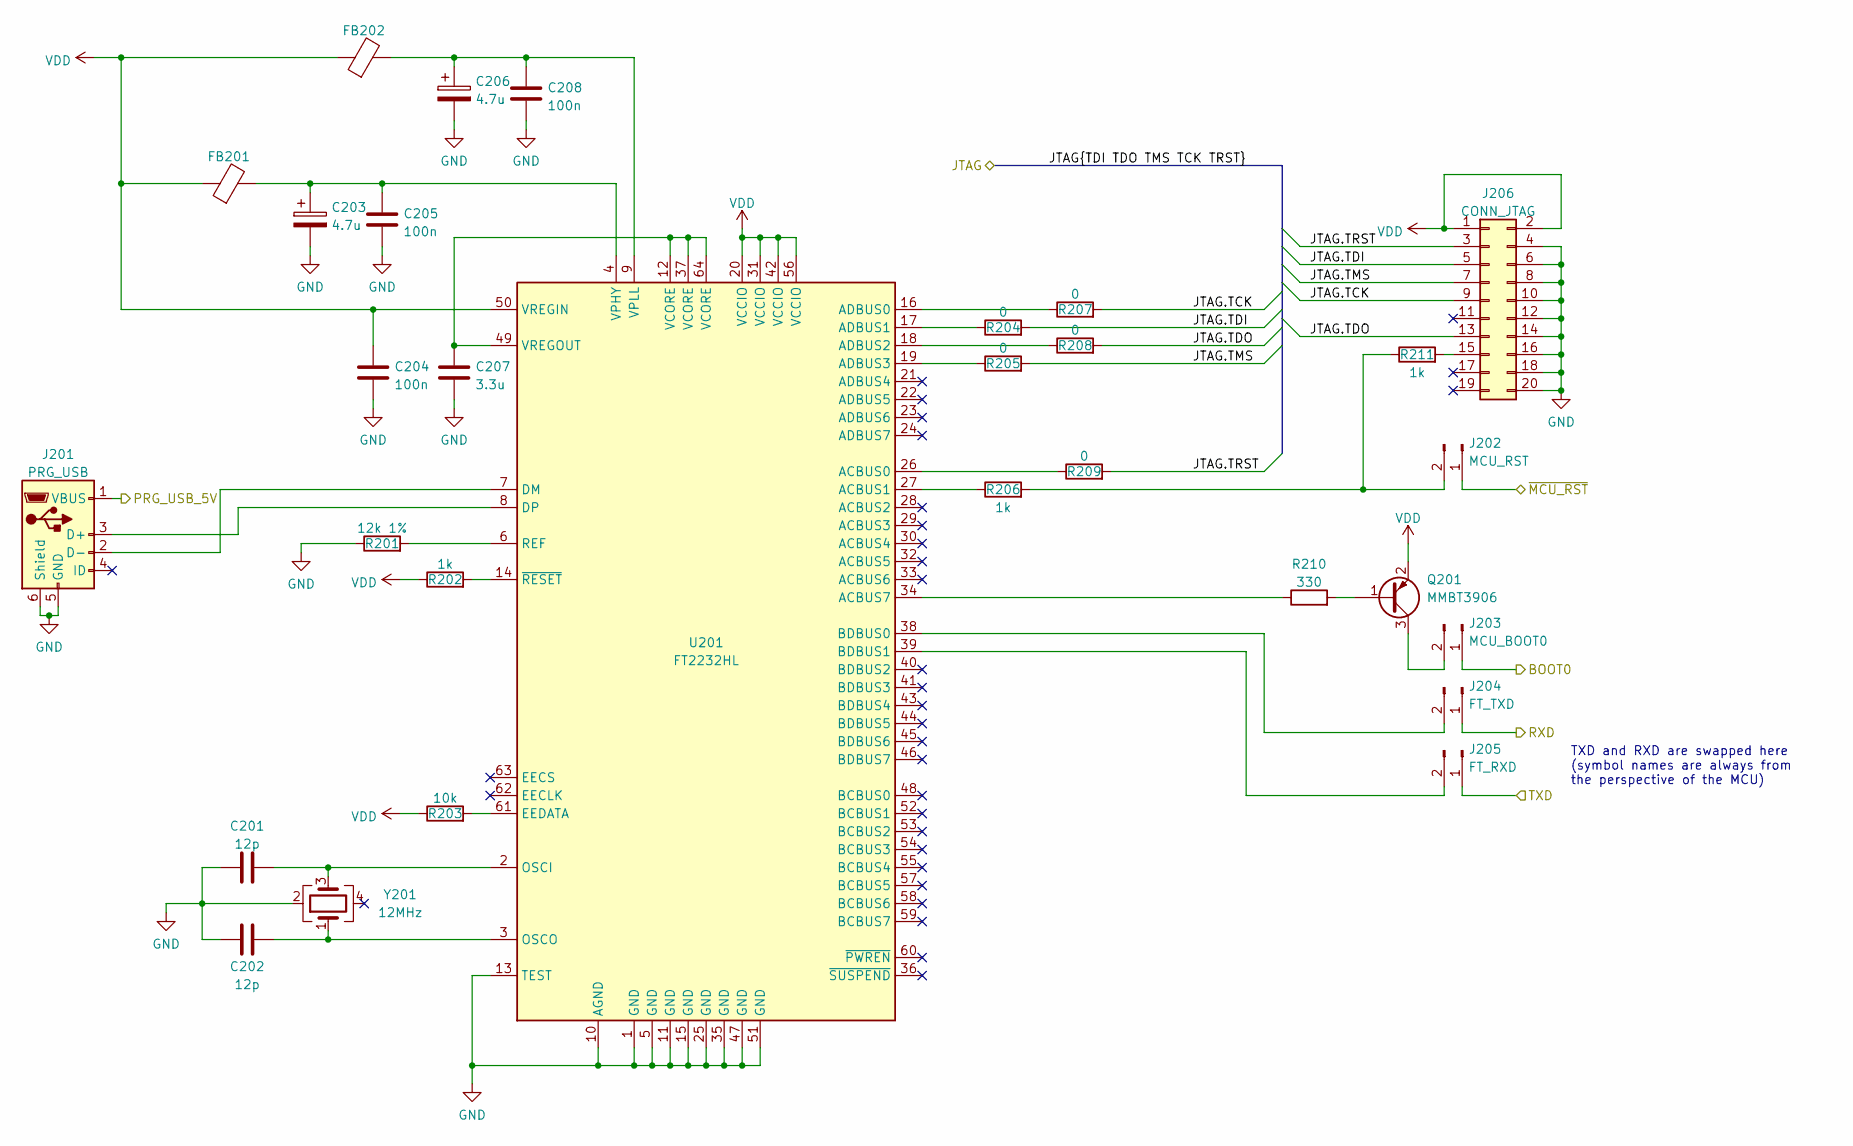
[picture p9: schematic prg-if.kicad_sch, MARCO RAM Board]

Parts:
C201, C202: 12p; C_0603_1608Metric_Pad1.08x0.95mm_HandSolder
C203, C206: 4.7u; CP_EIA-2012-15_AVX-P_Pad1.30x1.05mm_HandSolder; Part 647-F920J475MPA
C204, C205, C208: 100n; C_0603_1608Metric_Pad1.08x0.95mm_HandSolder
C207: 3.3u; C_0805_2012Metric_Pad1.18x1.45mm_HandSolder; Part 963-LMK212B7335KG-T
FB201, FB202: FerriteBead; L_0603_1608Metric_Pad1.05x0.95mm_HandSolder; Part 815-ACML-0603H-301
J201: PRG_USB; USB_Mini-B_Wuerth_65100516121_Horizontal
J202: MCU_RST; PinHeader_1x02_P2.54mm_Vertical
J203: MCU_BOOT0; PinHeader_1x02_P2.54mm_Vertical
J204: FT_TXD; PinHeader_1x02_P2.54mm_Vertical
J205: FT_RXD; PinHeader_1x02_P2.54mm_Vertical
J206: CONN_JTAG; PinSocket_2x10_P2.54mm_Vertical
Q201: MMBT3906; SOT-23
R201: 12k 1%; R_0603_1608Metric_Pad0.98x0.95mm_HandSolder
R202, R206, R211: 1k; R_0603_1608Metric_Pad0.98x0.95mm_HandSolder
R203: 10k; R_0603_1608Metric_Pad0.98x0.95mm_HandSolder
R204, R205, R207, R208, R209: 0; R_0603_1608Metric_Pad0.98x0.95mm_HandSolder
R210: 330; R_0603_1608Metric_Pad0.98x0.95mm_HandSolder
U201: FT2232HL; LQFP-64_10x10mm_P0.5mm
Y201: 12MHz; Crystal_SMD_5032-4Pin_5.0x3.2mm

Connections:
/mcu/BOOT0: J203.1; also elsewhere on the board
/mcu/JTAG.TCK: J206.9, R207.2; also elsewhere on the board
/mcu/JTAG.TDI: J206.5, R204.2; also elsewhere on the board
/mcu/JTAG.TDO: J206.13, R208.2; also elsewhere on the board
/mcu/JTAG.TMS: J206.7, R205.2; also elsewhere on the board
/mcu/JTAG.TRST: J206.3, R209.2; also elsewhere on the board
/mcu/RXD: J204.1; also elsewhere on the board
/mcu/TXD: J205.1; also elsewhere on the board
/mcu/~RESET: J202.1; also elsewhere on the board
/prg-if/PRG_USB_5V: J201.1 (VBUS)
GND: C201.1, C202.1, C203.2, C204.2, C205.2, C206.2, C207.2, C208.2, J201.5 (GND), J201.6 (Shield), J206.4, J206.6, J206.8, J206.10, J206.12, J206.14, J206.16, J206.18, J206.20, R201.1, U201.1 (GND), U201.5 (GND), U201.10 (AGND), U201.11 (GND), U201.13 (TEST), U201.15 (GND), U201.25 (GND), U201.35 (GND), U201.47 (GND), U201.51 (GND), Y201.2; also elsewhere on the board
unnamed: C201.2, U201.2 (OSCI), Y201.3
unnamed: C202.2, U201.3 (OSCO), Y201.1
unnamed: C203.1, C205.1, FB201.2, U201.4 (VPHY)
unnamed: C206.1, C208.1, FB202.2, U201.9 (VPLL)
unnamed: C207.1, U201.12 (VCORE), U201.37 (VCORE), U201.49 (VREGOUT), U201.64 (VCORE)
unnamed: J201.2 (D-), U201.7 (DM)
unnamed: J201.3 (D+), U201.8 (DP)
unnamed: J202.2, R206.2, R211.1
unnamed: J203.2, Q201.3 (C)
unnamed: J204.2, U201.38 (BDBUS0)
unnamed: J205.2, U201.39 (BDBUS1)
unnamed: J206.15, R211.2
unnamed: Q201.1 (B), R210.2
unnamed: R201.2, U201.6 (REF)
unnamed: R202.2, U201.14 (~RESET)
unnamed: R203.2, U201.61 (EEDATA)
unnamed: R204.1, U201.17 (ADBUS1)
unnamed: R205.1, U201.19 (ADBUS3)
unnamed: R206.1, U201.27 (ACBUS1)
unnamed: R207.1, U201.16 (ADBUS0)
unnamed: R208.1, U201.18 (ADBUS2)
unnamed: R209.1, U201.26 (ACBUS0)
unnamed: R210.1, U201.34 (ACBUS7)
VDD: C204.1, FB201.1, FB202.1, J206.1, J206.2, Q201.2 (E), R202.1, R203.1, U201.20 (VCCIO), U201.31 (VCCIO), U201.42 (VCCIO), U201.50 (VREGIN), U201.56 (VCCIO); also elsewhere on the board

Notes on the sheet:
TXD and RXD are swapped here (symbol names are always from the perspective of the MCU)

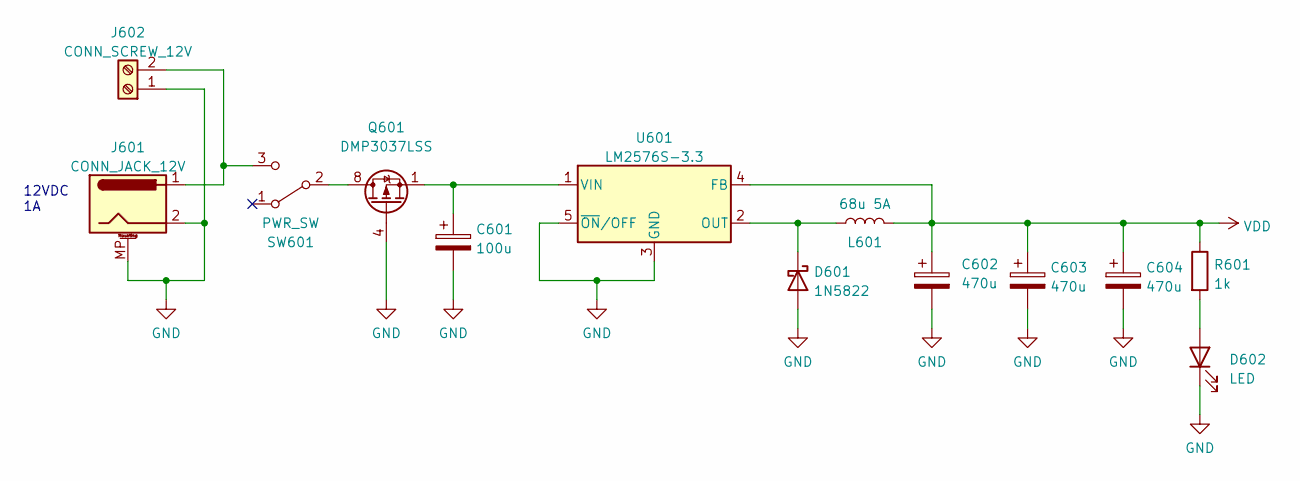
[picture p10: schematic power.kicad_sch, MARCO RAM Board]

Parts:
C601: 100u; CP_Radial_D6.3mm_P2.50mm; Part 710-860020473008
C602, C603, C604: 470u; CP_Radial_D8.0mm_P5.00mm; Part 667-EEU-FR1C471B
D601: 1N5822; D_DO-201AD_P5.08mm_Vertical_AnodeUp
D602: LED; LED_PLCC-2_3.4x3.0mm_KA
J601: CONN_JACK_12V; BarrelJack_CUI_PJ-063AH_Horizontal; Part 490-PJ-063AH
J602: CONN_SCREW_12V; TerminalBlock_Phoenix_MKDS-1,5-2-5.08_1x02_P5.08mm_Horizont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
L601: 68u 5A; L_Toroid_Vertical_L24.6mm_W15.5mm_P11.44mm_Pulse_KM-4; Part PE-92114KNL
Q601: DMP3037LSS; SOIC-8_3.9x4.9mm_P1.27mm
R601: 1k; R_0603_1608Metric_Pad0.98x0.95mm_HandSolder
SW601: PWR_SW; SW_Slide_CuK_1101M2xxAxx2_SPDT_RightAngle; Part 611-L101011MS02Q
U601: LM2576S-3.3; TO-263-5_TabPin3

Connections:
GND: C601.2, C602.2, C603.2, C604.2, D601.2 (A), D602.1 (K), J601.2, J601.MP (MountPin), J602.1, Q601.4 (G), U601.3 (GND), U601.5 (~ON/OFF); also elsewhere on the board
unnamed: C601.1, Q601.1 (S), Q601.2 (S), Q601.3 (S), U601.1 (VIN)
unnamed: D601.1 (K), L601.1, U601.2 (OUT)
unnamed: D602.2 (A), R601.2
unnamed: J601.1, J602.2, SW601.3 (C)
unnamed: Q601.5 (D), Q601.6 (D), Q601.7 (D), Q601.8 (D), SW601.2 (B)
VDD: C602.1, C603.1, C604.1, L601.2, R601.1, U601.4 (FB); also elsewhere on the board

Notes on the sheet:
12VDC 1A

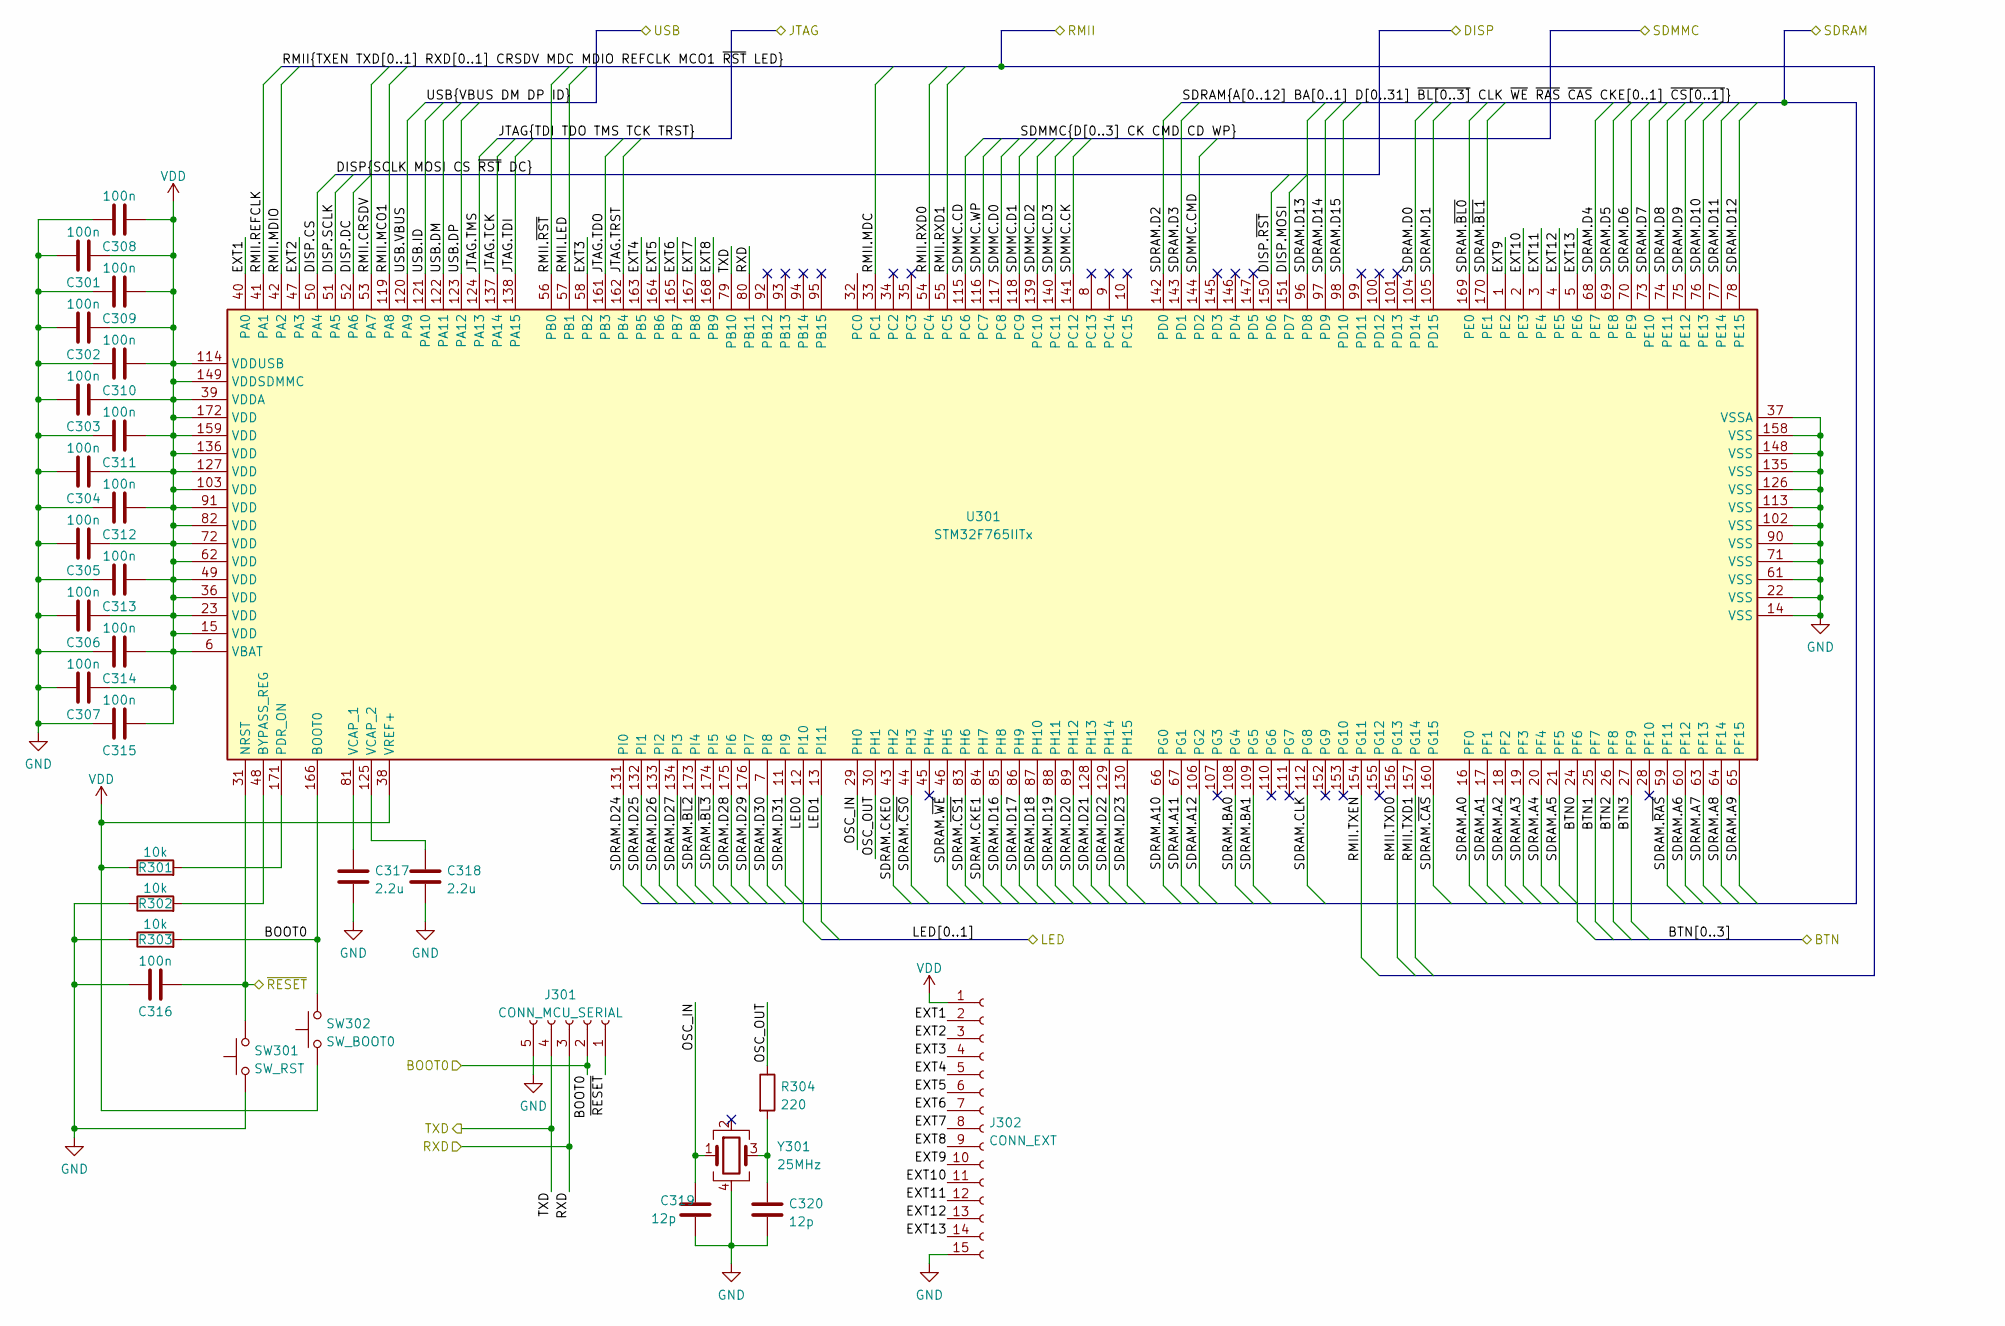
[picture p11: schematic mcu.kicad_sch, MARCO RAM Board]

Parts:
C301, C302, C303, C304, C305, C306, C307, C308, C309, C310, C311, C312, C313, C314, C315, C316: 100n; C_0603_1608Metric_Pad1.08x0.95mm_HandSolder
C317, C318: 2.2u; C_0805_2012Metric_Pad1.18x1.45mm_HandSolder
C319, C320: 12p; C_0603_1608Metric_Pad1.08x0.95mm_HandSolder
J301: CONN_MCU_SERIAL; PinSocket_1x05_P2.54mm_Vertical
J302: CONN_EXT; PinSocket_1x15_P2.54mm_Vertical
R301, R302, R303: 10k; R_0603_1608Metric_Pad0.98x0.95mm_HandSolder
R304: 220; R_0603_1608Metric_Pad0.98x0.95mm_HandSolder
SW301: SW_RST; DTSMW69N
SW302: SW_BOOT0; DTSMW69N
U301: STM32F765IITx; LQFP-176_24x24mm_P0.5mm
Y301: 25MHz; Crystal_SMD_5032-4Pin_5.0x3.2mm

Connections:
/mcu-if/BTN0: U301.24 (PF6); also elsewhere on the board
/mcu-if/BTN1: U301.25 (PF7); also elsewhere on the board
/mcu-if/BTN2: U301.26 (PF8); also elsewhere on the board
/mcu-if/BTN3: U301.27 (PF9); also elsewhere on the board
/mcu-if/DISP.CS: U301.50 (PA4); also elsewhere on the board
/mcu-if/DISP.DC: U301.52 (PA6); also elsewhere on the board
/mcu-if/DISP.MOSI: U301.151 (PD7); also elsewhere on the board
/mcu-if/DISP.SCLK: U301.51 (PA5); also elsewhere on the board
/mcu-if/DISP.~RST: U301.150 (PD6); also elsewhere on the board
/mcu-if/LED0: U301.12 (PI10); also elsewhere on the board
/mcu-if/LED1: U301.13 (PI11); also elsewhere on the board
/mcu-if/RMII.CRSDV: U301.53 (PA7); also elsewhere on the board
/mcu-if/RMII.LED: U301.57 (PB1); also elsewhere on the board
/mcu-if/RMII.MCO1: U301.119 (PA8); also elsewhere on the board
/mcu-if/RMII.MDC: U301.33 (PC1); also elsewhere on the board
/mcu-if/RMII.MDIO: U301.42 (PA2); also elsewhere on the board
/mcu-if/RMII.REFCLK: U301.41 (PA1); also elsewhere on the board
/mcu-if/RMII.RXD0: U301.54 (PC4); also elsewhere on the board
/mcu-if/RMII.RXD1: U301.55 (PC5); also elsewhere on the board
/mcu-if/RMII.TXD0: U301.156 (PG13); also elsewhere on the board
/mcu-if/RMII.TXD1: U301.157 (PG14); also elsewhere on the board
/mcu-if/RMII.TXEN: U301.154 (PG11); also elsewhere on the board
/mcu-if/RMII.~RST: U301.56 (PB0); also elsewhere on the board
/mcu-if/SDMMC.CD: U301.115 (PC6); also elsewhere on the board
/mcu-if/SDMMC.CK: U301.141 (PC12); also elsewhere on the board
/mcu-if/SDMMC.CMD: U301.144 (PD2); also elsewhere on the board
/mcu-if/SDMMC.D0: U301.117 (PC8); also elsewhere on the board
/mcu-if/SDMMC.D1: U301.118 (PC9); also elsewhere on the board
/mcu-if/SDMMC.D2: U301.139 (PC10); also elsewhere on the board
/mcu-if/SDMMC.D3: U301.140 (PC11); also elsewhere on the board
/mcu-if/SDMMC.WP: U301.116 (PC7); also elsewhere on the board
/mcu-if/USB.DM: U301.122 (PA11); also elsewhere on the board
/mcu-if/USB.DP: U301.123 (PA12); also elsewhere on the board
/mcu-if/USB.ID: U301.121 (PA10); also elsewhere on the board
/mcu-if/USB.VBUS: U301.120 (PA9); also elsewhere on the board
/mcu/BOOT0: J301.2, R303.2, SW302.2, U301.166 (BOOT0); also elsewhere on the board
/mcu/EXT1: J302.2, U301.40 (PA0)
/mcu/EXT2: J302.3, U301.47 (PA3)
/mcu/EXT3: J302.4, U301.58 (PB2)
/mcu/EXT4: J302.5, U301.163 (PB5)
/mcu/EXT5: J302.6, U301.164 (PB6)
/mcu/EXT6: J302.7, U301.165 (PB7)
/mcu/EXT7: J302.8, U301.167 (PB8)
/mcu/EXT8: J302.9, U301.168 (PB9)
/mcu/EXT9: J302.10, U301.1 (PE2)
/mcu/EXT10: J302.11, U301.2 (PE3)
/mcu/EXT11: J302.12, U301.3 (PE4)
/mcu/EXT12: J302.13, U301.4 (PE5)
/mcu/EXT13: J302.14, U301.5 (PE6)
/mcu/JTAG.TCK: U301.137 (PA14); also elsewhere on the board
/mcu/JTAG.TDI: U301.138 (PA15); also elsewhere on the board
/mcu/JTAG.TDO: U301.161 (PB3); also elsewhere on the board
/mcu/JTAG.TMS: U301.124 (PA13); also elsewhere on the board
/mcu/JTAG.TRST: U301.162 (PB4); also elsewhere on the board
/mcu/OSC_IN: C319.1, U301.29 (PH0), Y301.1
/mcu/OSC_OUT: R304.1, U301.30 (PH1)
/mcu/RXD: J301.3, U301.80 (PB11); also elsewhere on the board
/mcu/SDRAM.A0: U301.16 (PF0); also elsewhere on the board
/mcu/SDRAM.A1: U301.17 (PF1); also elsewhere on the board
/mcu/SDRAM.A2: U301.18 (PF2); also elsewhere on the board
/mcu/SDRAM.A3: U301.19 (PF3); also elsewhere on the board
/mcu/SDRAM.A4: U301.20 (PF4); also elsewhere on the board
/mcu/SDRAM.A5: U301.21 (PF5); also elsewhere on the board
/mcu/SDRAM.A6: U301.60 (PF12); also elsewhere on the board
/mcu/SDRAM.A7: U301.63 (PF13); also elsewhere on the board
/mcu/SDRAM.A8: U301.64 (PF14); also elsewhere on the board
/mcu/SDRAM.A9: U301.65 (PF15); also elsewhere on the board
/mcu/SDRAM.A10: U301.66 (PG0); also elsewhere on the board
/mcu/SDRAM.A11: U301.67 (PG1); also elsewhere on the board
/mcu/SDRAM.A12: U301.106 (PG2); also elsewhere on the board
/mcu/SDRAM.BA0: U301.108 (PG4); also elsewhere on the board
/mcu/SDRAM.BA1: U301.109 (PG5); also elsewhere on the board
/mcu/SDRAM.CKE0: U301.43 (PH2); also elsewhere on the board
/mcu/SDRAM.CKE1: U301.84 (PH7); also elsewhere on the board
/mcu/SDRAM.CLK: U301.112 (PG8); also elsewhere on the board
/mcu/SDRAM.D0: U301.104 (PD14); also elsewhere on the board
/mcu/SDRAM.D1: U301.105 (PD15); also elsewhere on the board
/mcu/SDRAM.D2: U301.142 (PD0); also elsewhere on the board
/mcu/SDRAM.D3: U301.143 (PD1); also elsewhere on the board
/mcu/SDRAM.D4: U301.68 (PE7); also elsewhere on the board
/mcu/SDRAM.D5: U301.69 (PE8); also elsewhere on the board
/mcu/SDRAM.D6: U301.70 (PE9); also elsewhere on the board
/mcu/SDRAM.D7: U301.73 (PE10); also elsewhere on the board
/mcu/SDRAM.D8: U301.74 (PE11); also elsewhere on the board
/mcu/SDRAM.D9: U301.75 (PE12); also elsewhere on the board
/mcu/SDRAM.D10: U301.76 (PE13); also elsewhere on the board
/mcu/SDRAM.D11: U301.77 (PE14); also elsewhere on the board
/mcu/SDRAM.D12: U301.78 (PE15); also elsewhere on the board
/mcu/SDRAM.D13: U301.96 (PD8); also elsewhere on the board
/mcu/SDRAM.D14: U301.97 (PD9); also elsewhere on the board
/mcu/SDRAM.D15: U301.98 (PD10); also elsewhere on the board
/mcu/SDRAM.D16: U301.85 (PH8); also elsewhere on the board
/mcu/SDRAM.D17: U301.86 (PH9); also elsewhere on the board
/mcu/SDRAM.D18: U301.87 (PH10); also elsewhere on the board
/mcu/SDRAM.D19: U301.88 (PH11); also elsewhere on the board
/mcu/SDRAM.D20: U301.89 (PH12); also elsewhere on the board
/mcu/SDRAM.D21: U301.128 (PH13); also elsewhere on the board
/mcu/SDRAM.D22: U301.129 (PH14); also elsewhere on the board
/mcu/SDRAM.D23: U301.130 (PH15); also elsewhere on the board
/mcu/SDRAM.D24: U301.131 (PI0); also elsewhere on the board
/mcu/SDRAM.D25: U301.132 (PI1); also elsewhere on the board
/mcu/SDRAM.D26: U301.133 (PI2); also elsewhere on the board
/mcu/SDRAM.D27: U301.134 (PI3); also elsewhere on the board
/mcu/SDRAM.D28: U301.175 (PI6); also elsewhere on the board
/mcu/SDRAM.D29: U301.176 (PI7); also elsewhere on the board
/mcu/SDRAM.D30: U301.7 (PI8); also elsewhere on the board
/mcu/SDRAM.D31: U301.11 (PI9); also elsewhere on the board
/mcu/SDRAM.~BL0: U301.169 (PE0); also elsewhere on the board
/mcu/SDRAM.~BL1: U301.170 (PE1); also elsewhere on the board
/mcu/SDRAM.~BL2: U301.173 (PI4); also elsewhere on the board
/mcu/SDRAM.~BL3: U301.174 (PI5); also elsewhere on the board
/mcu/SDRAM.~CAS: U301.160 (PG15); also elsewhere on the board
/mcu/SDRAM.~CS0: U301.44 (PH3); also elsewhere on the board
/mcu/SDRAM.~CS1: U301.83 (PH6); also elsewhere on the board
/mcu/SDRAM.~RAS: U301.59 (PF11); also elsewhere on the board
/mcu/SDRAM.~WE: U301.46 (PH5); also elsewhere on the board
/mcu/TXD: J301.4, U301.79 (PB10); also elsewhere on the board
/mcu/~RESET: C316.1, J301.1, SW301.2, U301.31 (NRST); also elsewhere on the board
GND: C301.2, C302.2, C303.2, C304.2, C305.2, C306.2, C307.2, C308.2, C309.2, C310.2, C311.2, C312.2, C313.2, C314.2, C315.2, C316.2, C317.2, C318.2, C319.2, C320.2, J301.5, J302.15, R302.1, R303.1, SW301.1, U301.14 (VSS), U301.22 (VSS), U301.37 (VSSA), U301.61 (VSS), U301.71 (VSS), U301.90 (VSS), U301.102 (VSS), U301.113 (VSS), U301.126 (VSS), U301.135 (VSS), U301.148 (VSS), U301.158 (VSS), Y301.4; also elsewhere on the board
unnamed: C317.1, U301.81 (VCAP_1)
unnamed: C318.1, U301.125 (VCAP_2)
unnamed: C320.1, R304.2, Y301.3
unnamed: R301.2, U301.171 (PDR_ON)
unnamed: R302.2, U301.48 (BYPASS_REG)
VDD: C301.1, C302.1, C303.1, C304.1, C305.1, C306.1, C307.1, C308.1, C309.1, C310.1, C311.1, C312.1, C313.1, C314.1, C315.1, J302.1, R301.1, SW302.1, U301.6 (VBAT), U301.15 (VDD), U301.23 (VDD), U301.36 (VDD), U301.38 (VREF+), U301.39 (VDDA), U301.49 (VDD), U301.62 (VDD), U301.72 (VDD), U301.82 (VDD), U301.91 (VDD), U301.103 (VDD), U301.114 (VDDUSB), U301.127 (VDD), U301.136 (VDD), U301.149 (VDDSDMMC), U301.159 (VDD), U301.172 (VDD); also elsewhere on the board
