HEAPLab/marco-ram-board/marco-ram-board.kicad_pcb

## KiCad design marco-ram-board.kicad_pcb (continued)

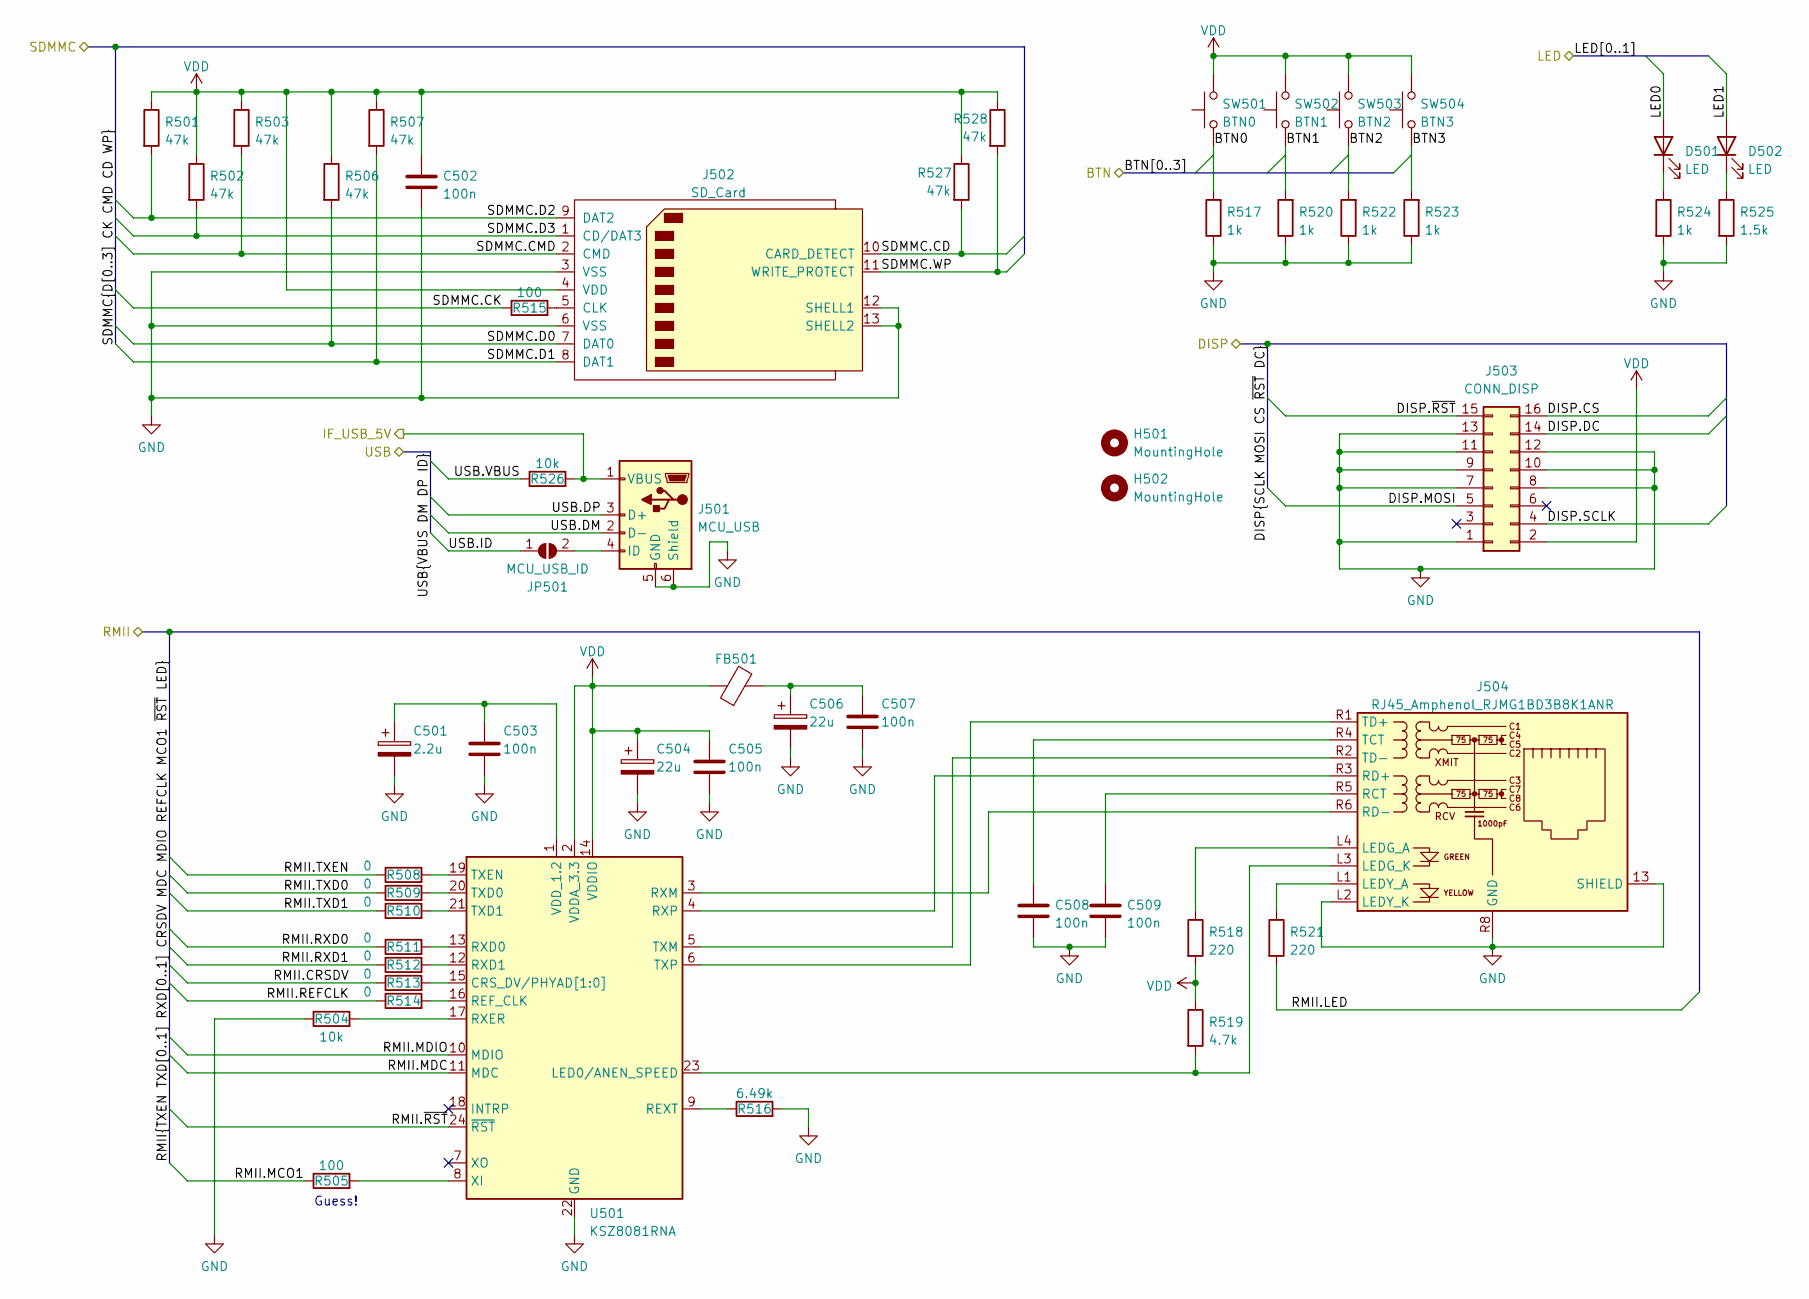
[picture p12: schematic mcu-if.kicad_sch, MARCO RAM Board]

Parts:
C501: 2.2u; C_0805_2012Metric_Pad1.18x1.45mm_HandSolder
C502, C503, C505, C507, C508, C509: 100n; C_0603_1608Metric_Pad1.08x0.95mm_HandSolder
C504, C506: 22u; CP_EIA-3216-18_Kemet-A_Pad1.58x1.35mm_HandSolder; Part 74-293D226X96R3A2TE3
D501, D502: LED; LED_PLCC-2_3.4x3.0mm_KA
FB501: FerriteBead; L_0603_1608Metric_Pad1.05x0.95mm_HandSolder; Part 815-ACML-0603H-301
H501, H502: MountingHole; MountingHole_2.7mm_M2.5
J501: MCU_USB; USB_Mini-B_Wuerth_65100516121_Horizontal
J502: SD_Card; SD_Hirose_DM1AA_SF_PEJ82
J503: CONN_DISP; PinSocket_2x08_P2.54mm_Vertical
J504: RJ45_Amphenol_RJMG1BD3B8K1ANR
JP501: MCU_USB_ID; SolderJumper-2_P1.3mm_Open_RoundedPad1.0x1.5mm
R501, R502, R503, R506, R507, R527, R528: 47k; R_0603_1608Metric_Pad0.98x0.95mm_HandSolder
R504, R526: 10k; R_0603_1608Metric_Pad0.98x0.95mm_HandSolder
R505, R515: 100; R_0603_1608Metric_Pad0.98x0.95mm_HandSolder
R508, R509, R510, R511, R512, R513, R514: 0; R_0603_1608Metric_Pad0.98x0.95mm_HandSolder
R516: 6.49k; R_0603_1608Metric_Pad0.98x0.95mm_HandSolder
R517, R520, R522, R523, R524: 1k; R_0603_1608Metric_Pad0.98x0.95mm_HandSolder
R518, R521: 220; R_0603_1608Metric_Pad0.98x0.95mm_HandSolder
R519: 4.7k; R_0603_1608Metric_Pad0.98x0.95mm_HandSolder
R525: 1.5k; R_0603_1608Metric_Pad0.98x0.95mm_HandSolder
SW501: BTN0; DTSMW69N
SW502: BTN1; DTSMW69N
SW503: BTN2; DTSMW69N
SW504: BTN3; DTSMW69N
U501: KSZ8081RNA; QFN-24-1EP_4x4mm_P0.5mm_EP2.6x2.6mm

Connections:
/mcu-if/BTN0: R517.2, SW501.1; also elsewhere on the board
/mcu-if/BTN1: R520.2, SW502.1; also elsewhere on the board
/mcu-if/BTN2: R522.2, SW503.1; also elsewhere on the board
/mcu-if/BTN3: R523.2, SW504.1; also elsewhere on the board
/mcu-if/DISP.CS: J503.16; also elsewhere on the board
/mcu-if/DISP.DC: J503.14; also elsewhere on the board
/mcu-if/DISP.MOSI: J503.5; also elsewhere on the board
/mcu-if/DISP.SCLK: J503.4; also elsewhere on the board
/mcu-if/DISP.~RST: J503.15; also elsewhere on the board
/mcu-if/IF_USB_5V: J501.1 (VBUS), R526.2
/mcu-if/LED0: D501.2 (A); also elsewhere on the board
/mcu-if/LED1: D502.2 (A); also elsewhere on the board
/mcu-if/RMII.CRSDV: R513.1; also elsewhere on the board
/mcu-if/RMII.LED: R521.2; also elsewhere on the board
/mcu-if/RMII.MCO1: R505.1; also elsewhere on the board
/mcu-if/RMII.MDC: U501.11 (MDC); also elsewhere on the board
/mcu-if/RMII.MDIO: U501.10 (MDIO); also elsewhere on the board
/mcu-if/RMII.REFCLK: R514.1; also elsewhere on the board
/mcu-if/RMII.RXD0: R511.1; also elsewhere on the board
/mcu-if/RMII.RXD1: R512.1; also elsewhere on the board
/mcu-if/RMII.TXD0: R509.1; also elsewhere on the board
/mcu-if/RMII.TXD1: R510.1; also elsewhere on the board
/mcu-if/RMII.TXEN: R508.1; also elsewhere on the board
/mcu-if/RMII.~RST: U501.24 (~RST); also elsewhere on the board
/mcu-if/SDMMC.CD: J502.10 (CARD_DETECT), R527.2; also elsewhere on the board
/mcu-if/SDMMC.CK: R515.1; also elsewhere on the board
/mcu-if/SDMMC.CMD: J502.2 (CMD), R503.2; also elsewhere on the board
/mcu-if/SDMMC.D0: J502.7 (DAT0), R506.2; also elsewhere on the board
/mcu-if/SDMMC.D1: J502.8 (DAT1), R507.2; also elsewhere on the board
/mcu-if/SDMMC.D2: J502.9 (DAT2), R501.2; also elsewhere on the board
/mcu-if/SDMMC.D3: J502.1 (CD/DAT3), R502.2; also elsewhere on the board
/mcu-if/SDMMC.WP: J502.11 (WRITE_PROTECT), R528.2; also elsewhere on the board
/mcu-if/USB.DM: J501.2 (D-); also elsewhere on the board
/mcu-if/USB.DP: J501.3 (D+); also elsewhere on the board
/mcu-if/USB.ID: JP501.1 (A); also elsewhere on the board
/mcu-if/USB.VBUS: R526.1; also elsewhere on the board
GND: C501.2, C502.2, C503.2, C504.2, C505.2, C506.2, C507.2, C508.2, C509.2, J501.5 (GND), J501.6 (Shield), J502.3 (VSS), J502.6 (VSS), J502.12 (SHELL1), J502.13 (SHELL2), J503.1, J503.7, J503.8, J503.9, J503.10, J503.11, J503.12, J503.13, J504.13 (SHIELD), J504.L2 (LEDY_K), J504.R8 (GND), R504.1, R516.2, R517.1, R520.1, R522.1, R523.1, R524.2, R525.2, U501.22 (GND), U501.25 (GND); also elsewhere on the board
unnamed: C501.1, C503.1, U501.1 (VDD_1.2)
unnamed: C506.1, C507.1, FB501.2
unnamed: C508.1, J504.R4 (TCT)
unnamed: C509.1, J504.R5 (RCT)
unnamed: D501.1 (K), R524.1
unnamed: D502.1 (K), R525.1
unnamed: J501.4 (ID), JP501.2 (B)
unnamed: J502.5 (CLK), R515.2
unnamed: J504.L1 (LEDY_A), R521.1
unnamed: J504.L3 (LEDG_K), R519.2, U501.23 (LED0/ANEN_SPEED)
unnamed: J504.L4 (LEDG_A), R518.1
unnamed: J504.R1 (TD+), U501.6 (TXP)
unnamed: J504.R2 (TD-), U501.5 (TXM)
unnamed: J504.R3 (RD+), U501.4 (RXP)
unnamed: J504.R6 (RD-), U501.3 (RXM)
unnamed: R504.2, U501.17 (RXER)
unnamed: R505.2, U501.8 (XI)
unnamed: R508.2, U501.19 (TXEN)
unnamed: R509.2, U501.20 (TXD0)
unnamed: R510.2, U501.21 (TXD1)
unnamed: R511.2, U501.13 (RXD0)
unnamed: R512.2, U501.12 (RXD1)
unnamed: R513.2, U501.15 (CRS_DV/PHYAD[1:0])
unnamed: R514.2, U501.16 (REF_CLK)
unnamed: R516.1, U501.9 (REXT)
VDD: C502.1, C504.1, C505.1, FB501.1, J502.4 (VDD), J503.2, R501.1, R502.1, R503.1, R506.1, R507.1, R518.2, R519.1, R527.1, R528.1, SW501.2, SW502.2, SW503.2, SW504.2, U501.2 (VDDA_3.3), U501.14 (VDDIO); also elsewhere on the board

Notes on the sheet:
Guess!

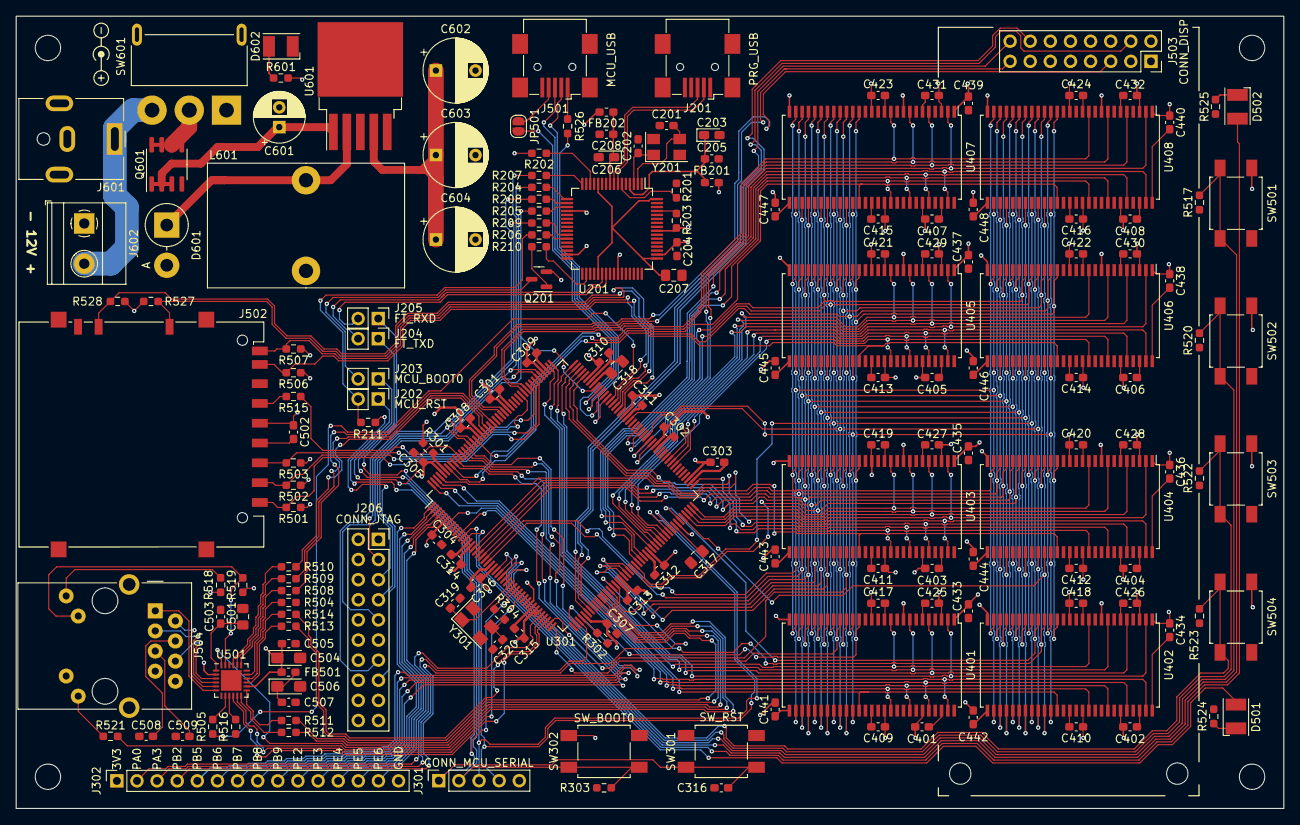
[picture p13: board marco-ram-board.kicad_pcb from above]

Board: 4 copper layers, 160.0 x 100.0 mm, 185 parts (0 on the bottom side), 179 nets.
