HEAPLab/marco-ram-board/rmii-test-firmware/Core/Src/main.c

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
/* Includes ------------------------------------------------------------------*/
#include "main.h"
#include "lwip.h"


UART_HandleTypeDef huart3;

void SystemClock_Config(void);
static void MX_GPIO_Init(void);
static void MX_USART3_UART_Init(void);
/**
  * @brief  The application entry point.
  * @retval int
  */
int main(void)
{
  /* MCU Configuration--------------------------------------------------------*/

  /* Reset of all peripherals, Initializes the Flash interface and the Systick. */
  HAL_Init();

  /* Configure the system clock */
  SystemClock_Config();

  /* Initialize all configured peripherals */
  MX_GPIO_Init();
  MX_USART3_UART_Init();
  HAL_GPIO_WritePin(GPIOB, GPIO_PIN_0|GPIO_PIN_1, GPIO_PIN_RESET);
  HAL_Delay(1);
  HAL_GPIO_WritePin(GPIOB, GPIO_PIN_0|GPIO_PIN_1, GPIO_PIN_SET);
  HAL_Delay(1);
  static const uint8_t msg[] = "Init LWIP...\r\n";
  HAL_UART_Transmit(&huart3, msg, sizeof(msg)-1, 1000000);
  MX_LWIP_Init();
  /* USER CODE BEGIN 2 */
  HAL_UART_Transmit(&huart3, "OK!\r\n", 5, 1000000);
  /* USER CODE END 2 */

  /* Infinite loop */
  /* USER CODE BEGIN WHILE */
  while (1)
  {
    /* USER CODE END WHILE */

    /* USER CODE BEGIN 3 */
    for (uint32_t t = HAL_GetTick(); HAL_GetTick()-t < 1000;) {
      MX_LWIP_Process();
    }
    if (dhcp_supplied_address(&gnetif)) {
      char buf[128];
      sprintf(buf, "Alive, DHCP-assigned IP = %s\r\n", ip4addr_ntoa(netif_ip4_addr(&gnetif)));
      HAL_UART_Transmit(&huart3, buf, strlen(buf), 1000000);
    } else {
      static const uint8_t msg[] = "Alive, no DHCP-assigned IP address\r\n";
      HAL_UART_Transmit(&huart3, msg, strlen(msg), 1000000);
    }
  }
  /* USER CODE END 3 */
}

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
