HEAPLab/marco-ram-board/rmii-test-firmware/rmii_tester.ioc

Mcu.UserName=STM32F765IITx
PA1.Signal=ETH_REF_CLK
PA2.Signal=ETH_MDIO
PA7.Signal=ETH_CRS_DV
PA8.Signal=RCC_MCO_1
PB0.Signal=GPIO_Output
PB1.Signal=GPIO_Output
PB10.Signal=USART3_TX
PB11.Signal=USART3_RX
PC1.Signal=ETH_MDC
PC4.Signal=ETH_RXD0
PC5.Signal=ETH_RXD1
PG11.Signal=ETH_TX_EN
PG13.Signal=ETH_TXD0
PG14.Signal=ETH_TXD1
PH0/OSC_IN.Signal=RCC_OSC_IN
PH1/OSC_OUT.Signal=RCC_OSC_OUT
