HEAPLab/marco-ram-board/(commit log)

2023-02-11 Initial design primarily done by Federico Terraneo.
    [marco-ram-board.kicad_sch, mcu.kicad_sch, prg-if.kicad_sch, ram.kicad_sch]
2023-02-11 Add datasheets of currently used components.
2023-02-11 Complete wiring of SDRAM.
    [mcu.kicad_sch, ram.kicad_sch]
2023-02-12 Add SD card connector.
    [marco-ram-board.kicad_sch, mcu-if.kicad_sch, mcu.kicad_sch, ram.kicad_sch]
2023-02-12 Some minor repositioning.
    [marco-ram-board.kicad_sch]
2023-02-14 Add power supply.
    [marco-ram-board.kicad_sch, mcu-if.kicad_sch, mcu.kicad_sch, power.kicad_sch, prg-if.kicad_sch, ram.kicad_sch]
2023-02-14 Add MCU USB
    [marco-ram-board.kicad_sch, mcu-if.kicad_sch, mcu.kicad_sch]
2023-02-25 More capacitors for PSU
    [marco-ram-board.kicad_sch, power.kicad_sch]
2023-02-25 Configured PCB sizes for either eurocircuits or pcbway
    [marco-ram-board.kicad_pcb]
2023-02-25 Screenshot of board configuration
2023-02-25 Power supply design fine tuning
    [marco-ram-board.kicad_sch, power.kicad_sch]
2023-02-25 Add Ethernet interface.
    [marco-ram-board.kicad_sch, mcu-if.kicad_sch, mcu.kicad_sch]
2023-02-25 Capacitor part assignment
    [marco-ram-board.kicad_sch, mcu-if.kicad_sch, mcu.kicad_sch, power.kicad_sch, prg-if.kicad_sch, ram.kicad_sch]
2023-02-25 Add display connector
    [marco-ram-board.kicad_sch, mcu-if.kicad_sch, mcu.kicad_sch, power.kicad_sch]
2023-02-25 Add extension connector, LEDs, buttons
    [marco-ram-board.kicad_sch, mcu-if.kicad_sch, mcu.kicad_sch, power.kicad_sch]
2023-02-25 Led datasheets
2023-02-25 Final annotate pass
    [marco-ram-board.kicad_sch, mcu-if.kicad_sch, mcu.kicad_sch, power.kicad_sch, prg-if.kicad_sch, ram.kicad_sch]
2023-02-25 ERC pass
    [marco-ram-board.kicad_sch, mcu-if.kicad_sch, mcu.kicad_sch, power.kicad_sch, prg-if.kicad_sch, ram.kicad_sch]
2023-02-25 Re-annotation, footprints
    [marco-ram-board.kicad_sch, mcu-if.kicad_sch, mcu.kicad_sch, prg-if.kicad_sch]
2023-02-25 Add button footprint
    [marco-ram-board.kicad_sch, mcu-if.kicad_sch, mcu.kicad_sch]
2023-02-26 More footprints
    [marco-ram-board.kicad_sch, mcu-if.kicad_sch, power.kicad_sch, prg-if.kicad_sch]
2023-02-26 Power switch footprint.
    This is the last footprint!
    [marco-ram-board.kicad_sch, power.kicad_sch]
2023-03-02 Also connect MCU USB VBUS and ID.
    Useful for detecting disconnections.
    [marco-ram-board.kicad_sch, mcu-if.kicad_sch, mcu.kicad_sch]
2023-03-02 Move programming USART to USART3 from USART1 because the pins configured by the bootloader on USART1 are now occupied.
    [marco-ram-board.kicad_sch, mcu-if.kicad_sch, mcu.kicad_sch]
2023-03-02 Disconnect USB ID pin by default, add a solder bridge to allow reconnecting if needed.
    [marco-ram-board.kicad_sch, mcu-if.kicad_sch]
2023-03-12 Fix led current limiting resistor values.
    [marco-ram-board.kicad_sch, mcu-if.kicad_sch, power.kicad_sch]
2023-03-12 Started placement
    [marco-ram-board.kicad_pcb, marco-ram-board.kicad_sch]
2023-03-12 Placement almost complete
    [marco-ram-board.kicad_pcb, marco-ram-board.kicad_sch, mcu-if.kicad_sch, mcu.kicad_sch, prg-if.kicad_sch]
2023-03-12 Removed marker added by mistake
    [marco-ram-board.kicad_pcb]
2023-03-13 Fix several footprints, adjust pcb layout.
    - Change footprint for power switch, add the switch's datasheet.
    - Rearrange power supply area of PCB to make new switch fit.
    - Fix SD card socket footprint to be compatible with the schematic symbol. Add its datasheet
    - Add pullups for SD card socket WP and CD (fixed footprint hardwires one side of the switches to GND)
    - Add datasheet for the barrel jack.
    [marco-ram-board.kicad_pcb, marco-ram-board.kicad_sch, mcu-if.kicad_sch, power.kicad_sch]
2023-03-13 Fix overlapped label on DRAM data bus causing D16 and D18 nets to be connected together.
    [marco-ram-board.kicad_pcb, marco-ram-board.kicad_sch, mcu.kicad_sch, power.kicad_sch, ram.kicad_sch]
2023-03-20 Finish placement, start routing.
    [marco-ram-board.kicad_pcb, marco-ram-board.kicad_sch, mcu.kicad_sch]
2023-03-20 Small placement modifications, change most routing to .2mm, more RAM routing
    [marco-ram-board.kicad_pcb]
2023-03-21 Finish RAM routing (except connections to MCU).
    [marco-ram-board.kicad_pcb]
2023-03-25 Add worksheet template with PoliMi logo.
    [marco-ram-board.kicad_sch, mcu-if.kicad_sch, mcu.kicad_sch, power.kicad_sch, prg-if.kicad_sch, ram.kicad_sch]
2023-03-25 Fix double connection on the SDRAM bus.
    [mcu.kicad_sch]
2023-04-02 Route power supply
    [marco-ram-board.kicad_pcb]
2023-04-02 Update layout from schematic to propagate effects of commit b3d85d6.
    [marco-ram-board.kicad_pcb]
2023-04-17 Fix missing connections in SDRAM.
    [marco-ram-board.kicad_pcb]
2023-04-17 Bring out all SDRAM BUS elements from the SDRAM section from the closest point to the MCU
    [marco-ram-board.kicad_pcb]
2023-04-17 Route SDRAM. Whew!
    [marco-ram-board.kicad_pcb]
2023-04-19 SDRAM routing cleanup
    [marco-ram-board.kicad_pcb]
2023-04-19 MCU USB
    [marco-ram-board.kicad_pcb]
2023-04-19 More SDRAM routing cleanup, partial screen/buttons routing
    [marco-ram-board.kicad_pcb]
2023-04-20 Screen/buttons/LEDs routing
    [marco-ram-board.kicad_pcb]
2023-04-21 Properly set unconnected tag on unused MCU pins
    [mcu.kicad_sch]
2023-04-21 Use 0.15mm track width for all signals, not just the SDRAM.
    [marco-ram-board.kicad_pcb]
2023-04-21 Route SDMMC
    [marco-ram-board.kicad_pcb]
2023-04-21 Route debug JTAG and serial.
    [marco-ram-board.kicad_pcb]
2023-04-21 Artwork cleanup
    [marco-ram-board.kicad_pcb]
2023-04-23 Fix missing EXT9 connection, move EXT9-13 to PEx, route EXT connector.
    [marco-ram-board.kicad_pcb, mcu.kicad_sch]
2023-04-23 Add names to Ext connector pins.
    [marco-ram-board.kicad_pcb]
2023-04-23 Route RMII.
    [marco-ram-board.kicad_pcb]
2023-04-23 Route VDD.
    [marco-ram-board.kicad_pcb]
2023-04-24 Add additional silkscreen items, add 3D models for power switch.
2023-05-07 Delay line for SDRAM CLK.
    [marco-ram-board.kicad_sch, mcu.kicad_sch]
2023-05-07 Keepout zones under unregulated voltage and clock oscillator.
2023-05-14 Minor track cleanup
2023-07-01 Fix C501 symbol, it is a non polarized ceramic
    [mcu-if.kicad_sch]
2023-07-01 Fix ferrite bead from the wrong side
    [marco-ram-board.kicad_sch, mcu-if.kicad_sch]
2023-07-01 Fix base resistor value
    [marco-ram-board.kicad_sch, marco-ram-board.ods, prg-if.kicad_sch]
2023-07-01 BON consolidation
    [marco-ram-board.kicad_sch, marco-ram-board.ods, mcu-if.kicad_sch]
2023-07-01 BOM consolidations
    [marco-ram-board.kicad_sch, marco-ram-board.ods, mcu-if.kicad_sch]
2023-09-15 Update gerbers and gerber generation options per JLCPCB's guidelines.
    [marco-ram-board-B_Cu.gbl, marco-ram-board-B_Cu.gbr, marco-ram-board-B_Mask.gbr, marco-ram-board-B_Mask.gbs, marco-ram-board-B_Paste.gbp, marco-ram-board-B_Paste.gbr, marco-ram-board-B_Silkscreen.gbo, marco-ram-board-B_Silkscreen.gbr]
2023-09-15 Add board specification file for JLCPCB.
2023-09-28 Fully update PCB and schematic after BOM consolidation
    [marco-ram-board.kicad_sch, mcu-if.kicad_sch, mcu.kicad_sch, power.kicad_sch, prg-if.kicad_sch, ram.kicad_sch]
2023-09-28 Move labels on switches, jumpers and so on to a separate Label property from the Value property.
    Value must be the same for components that are physically the same, otherwise it screws up the BOM. But that means we need to add each label manually.
    [marco-ram-board.kicad_sch, mcu-if.kicad_sch, mcu.kicad_sch, power.kicad_sch, prg-if.kicad_sch]
2023-09-28 Generate interactive BOM
2023-09-28 Move BOM .ods to the bom directory
    [marco-ram-board.ods]
2023-09-28 Add PDF schematic
2023-12-23 Add source code of RMII test firmware for the board.
